wyolum/alamode/examples/train_demo/www/images/right.png

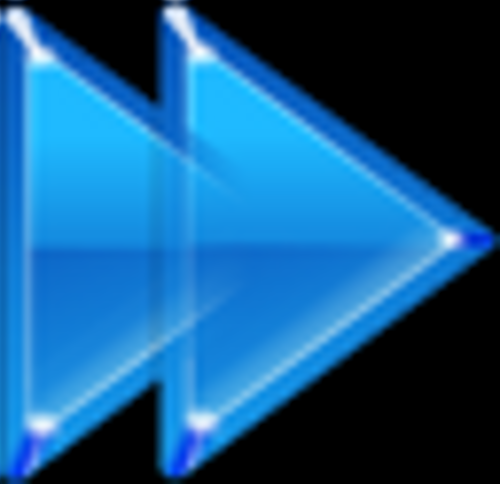
examples/train_demo/www/images/right.png
