wyolum/alamode/examples/train_demo/www/images/left.png

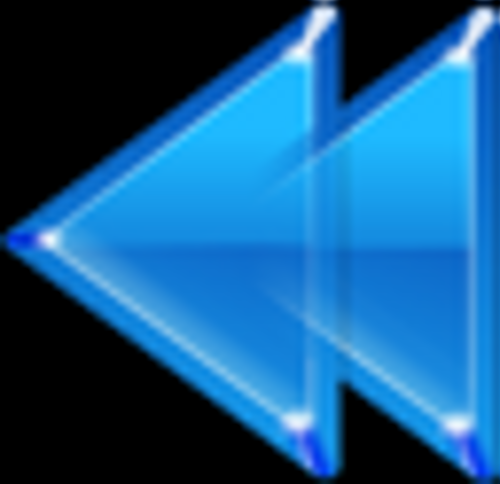
examples/train_demo/www/images/left.png
