wyolum/alamode/README.md

alamode
=======

Code, test code, and examples for the Alamode Arduino Compatible add on for Raspberry Pi.

License
-------
[CERN Open Hardware Licence v1.2 ]

[CERN Open Hardware Licence v1.2 ]:http://www.ohwr.org/attachments/2388/cern_ohl_v_1_2.txt
