wyolum/alamode/examples/train_demo/readme.md

Alamode Demo:

Control a lego train from a web interface.
Hardware requirements:
	Raspberry Pi
	AlaMode
	Adafruit Motor Shield
	Lego train (or other charged rail train system)
Software requirements:
	 Arduino IDE (or load alamode on another computer)
	 lighttpd (webserver). Could be adapted for other webservers such
	 as Apache.

Directory Structure:
alsmode-sketches: Copy these into your Arduino sketchbook
www: copy to /var/www or whatever your web root is
