wyolum/alamode/collateral/alamode sticker.png

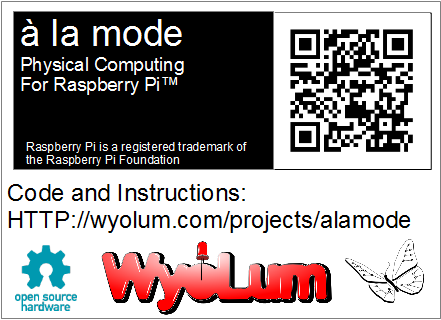
collateral/alamode sticker.png
