wyolum/alamode/examples/train_demo/www/images/but_left.png

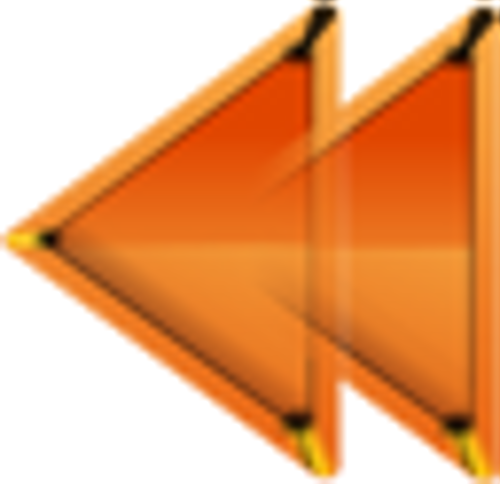
examples/train_demo/www/images/but_left.png
