wyolum/alamode/examples/train_demo/www/images/but_right.png

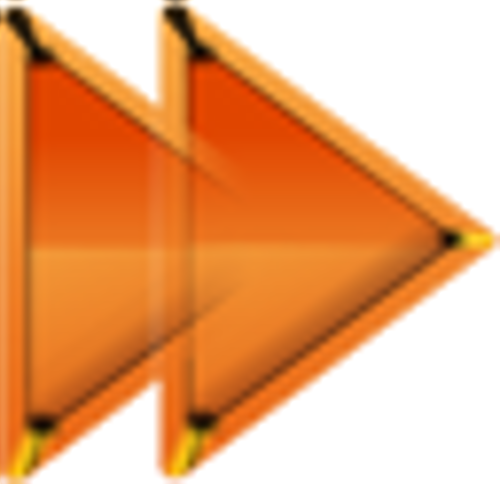
examples/train_demo/www/images/but_right.png
