wyolum/alamode/examples/train_demo/www/images/but_stop.png

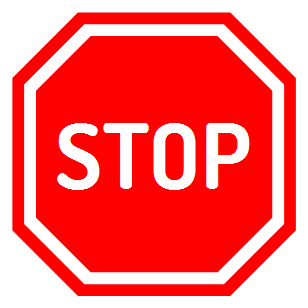
examples/train_demo/www/images/but_stop.png
