wyolum/alamode/examples/train_demo/www/images/WyoLum_v6.1.png

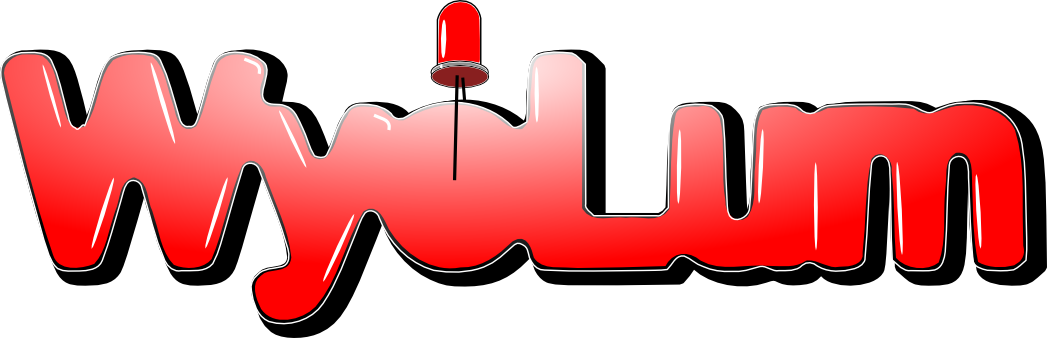
examples/train_demo/www/images/WyoLum_v6.1.png
