wyolum/alamode/kicad/Seeed BOM_aLamode_v3.ods

Sheet: Seeed BOM Format
Electronic Engineering BOM List
Product Name： WYOLUM AlaMode
Version：V3.0
Issue Date：29/Jul/2015
Item No. (序号) | Reference Des (上件位置) | Qty (用量) | Catalog (分类） | Part_Description (规格描述) | Part_Value （元件值） | Part_Package （元件封装） | Manufacturers Name (使用厂牌名称) | Manufacturers Part No. (使用厂牌型号) | Distributors Name （供应商名称） | Distributors Part No. (供貨商型号) | Unit Price （单价） | Price Break To Use （价格分段的购买量） | Notes/Remark （备注）
Example（填写范例）
1 | BT1 | 1 | OTHER | HOLDER COIN CELL 1632 GOLD SMD | Coin Cell, Holder, 1632 | CR1632 | MPD (Memory Protection Devices) | BU1632SM-JJ-GTR | Digikey (http://www.digikey.com/product-detail/en/BU1632SM-JJ-GTR/BU1632SM-JJ-GCT-ND/2079910) | BU1632SM-JJ-GCT-ND
2 | -- | 1 | OTHER | BATTERY LITHIUM COIN 3V 16MM | CR1632 | -- | Panasonic - BSG | CR1632 | DigiKey (http://www.digikey.com/product-detail/en/CR1632/P036-ND/269743?cur=USD) | P036-ND |  |  | DNP
3 | C1 C2 C4 C7 C9 C12 C13 C14 | 8 | Capacitor | CAP CER 0.1UF 25V 10% X7R 0805 | 100n 25V | 0805 (2012 Metric) | Kemet | C0805C104K3RACTU | DigiKey (http://www.digikey.com/product-detail/en/C0805C104K3RACTU/399-1168-1-ND/411443) | 399-1168-1-ND
4 | C3 | 1 | Capacitor | CAP TANT 2.2UF 10V 20% 0805 | 2u2 10V Tant | 0805 (2012 Metric) | Nichicon | F921A225MPA | DigiKey (http://www.digikey.com/product-detail/en/F921A225MPA/493-2331-1-ND/677799?cur=USD) | 493-2331-1-ND
5 | C5 | 1 | Capacitor | CAP CER 2.2UF 16V Y5V 0805 | 2u2, Ceramic | 0805 (2012 Metric) | TDK Corporation | C2012Y5V1C225Z/0.85 | DigiKey (http://goo.gl/59sIb) | 445-3459-1-ND
6 | C6 | 1 | Capacitor | CAP ALUM 100UF 25V 20% SMD | 100u, 25V | Radial, Can – SMD, 6.3diax7.7H,mm | Nichicon | UCL1E101MCL1GS | DigiKey (http://www.digikey.com/product-detail/en/UCL1E101MCL1GS/493-3937-1-ND/2300364) | 493-3937-1-ND
7 | C8 | 1 | Capacitor | CAP ALUM 47UF 10V 20% SMD | 47u, 10V | Radial, Can – SMD, 5.0diax5.4H,mm | Panasonic Electronic Components | EEE-1AA470WR | DigiKey (http://www.digikey.com/product-detail/en/EEE-1AA470WR/PCE3875CT-ND/766251?cur=USD) | PCE3875CT-ND
8 | C10 C11 | 2 | Capacitor | CAP CER 22PF 50V 5% NP0 0805 | 22p | 0805 (2012 Metric) | Kemet | C0805C220J5GACTU | DigiKey (http://www.digikey.com/product-detail/en/C0805C220J5GACTU/399-1113-1-ND/411388) | 399-1113-1-ND
9 | C15 | 1 | Capacitor | CAP CER 1000PF 50V 10% X7R 0805 | 1n | 0805 (2012 Metric) | Kemet | C0805C102K5RACTU | DigiKey (http://www.digikey.com/product-detail/en/C0805C102K5RACTU/399-1147-1-ND/411422) | 478-6218-1-ND
10 | C16 | 1 | Capacitor | CAP CER 10000PF 50V 10% X7R 0805 | 10n | 0805 (2012 Metric) | Kemet | C0805C103K5RACTU | DigiKey (http://www.digikey.com/product-detail/en/C0805C103K5RACTU/399-1158-1-ND/411433) | 399-1158-1-ND
11 | D1 D2 D13 | 3 | Diode | LED MINI TOPLED GREEN 570NM SMD | Green 1.8V 2mA LED | 2-SMD, J-Lead | OSRAM Opto Semiconductors Inc | LG M67K-H1J2-24-Z | DigiKey (http://www.digikey.com/product-detail/en/LG%20M67K-H1J2-24-Z/475-2730-1-ND/1938897?cur=USD) | 475-2730-1-ND
12 | D3 D4 | 2 | Diode | DIODE SCHOTTKY 5V 0.01A 2VMD | RB886G | 2-SMD, Flat Lead, VMD2 | Rohm Semiconductor | RB886GT2R | DigiKey (http://www.digikey.com/product-detail/en/RB886GT2R/RB886GT2RCT-ND/2425047?cur=USD) | RB886GT2RCT-ND
13 | D7 | 1 | Diode | TVS 600W 5.0V BI-DIR DO-214AA | SMBJ5.0CA-TR | DO-214AA, SMB | STMicroelectronics | SMBJ5.0CA-TR | DigiKey (http://www.digikey.com/product-detail/en/SMBJ5.0CA-TR/497-3145-1-ND/654466) | 497-3145-1-ND
14 | D8 | 1 | Diode | DIODE SCHOTTKY 10V 1A POWERMITE | MBRM110LT1G | DO-216AA | ON Semiconductor | MBRM110LT1G | DigiKey (http://www.digikey.com/product-detail/en/MBRM110LT1G/MBRM110LT1GOSCT-ND/917992) | MBRM110LT1GOSCT-ND
15 | F1 F2 | 2 | PROTECTOR CATEGORY | POLYSWITCH 1.10A RESET FUSE SMD | nanoSMDC110F | 1206 (3216 Metric), Concave, Long Side Terminals | TE Connectivity | NANOSMDC110F-2 | DigiKey (http://www.digikey.com/product-detail/en/NANOSMDC110F-2/NANOSMDC110FCT-ND/1045864) | NANOSMDC110FCT-ND
16 | IC1 | 1 | IC | IC MCU 8BIT 32KB FLASH 28DIP | ATMEGA328-PU | DIP-28__300_ELL | Atmel | ATMEGA328-PU | DigiKey (http://www.digikey.com/product-detail/en/ATMEGA328-PU/ATMEGA328-PU-ND/2271026?cur=USD) | ATMEGA328-PU-ND
17 | DIP1 | 1 | OTHER | CONN IC SOCKET VERT 28POS TIN | DIP28x0.3” | DIP28x0.3” | TE Connectivity | 1-390261-9 | DigiKey (http://www.digikey.com/product-detail/en/1-390261-9/A100210-ND/990628?cur=USD) | A100210-ND
18 | P12 | 1 | Connector | CONN USB MICRO B RECPT SMT R/A | USB - micro B | Surface Mount, Right Angle, Horizontal | FCI | 10118193-0001LF | DigiKey (http://www.digikey.com/product-detail/en/10118193-0001LF/609-4616-1-ND/2785380) | 609-4616-1-ND
19 | P16 | 1 | Connector | CONN HEADER 3POS 1.27MM SNGL SMD | 5V_LINK | Surface Mount 0.050" (1.27mm) | Samtec Inc | FTR-103-02-S-S | DigiKey (http://www.digikey.com/product-detail/en/FTR-103-02-S-S/FTR-103-02-S-S-ND/2651168) | FTR-103-02-S-S-ND
20 | Q1 | 1 | Transistor | MOSFET P-CH 20V 2A SSOT3 | FDN340P | SOT23-3 | Fairchild Semiconductor | FDN340P | DigiKey (http://www.digikey.com/product-detail/en/FDN340P/FDN340PCT-ND/965604) | FDN340PCT-ND
21 | R1 R2 R3 R4 R6 R7 R9 R10 R11 R13 | 10 | Resister | RES 10K OHM 1/8W 5% 0805 | 10k | 0805 (2012 Metric) | Stackpole Electronics Inc | RMCF0805JT10K0 | DigiKey (http://www.digikey.com/product-detail/en/RMCF0805JT10K0/RMCF0805JT10K0CT-ND/1942577) | RMCF0805JT10K0CT-ND
22 | R5 R8 | 2 | Resister | RES 1.5K OHM 1/8W 5% 0805 | 1k5 | 0805 (2012 Metric) | Stackpole Electronics Inc | RMCF0805JT1K50 | DigiKey (http://www.digikey.com/product-detail/en/RMCF0805JT1K50/RMCF0805JT1K50CT-ND/1942560) | RMCF0805JT1K50CT-ND
23 | R12 | 1 | Resister | RES 1K OHM 1/8W 5% 0805 | 1k | 0805 (2012 Metric) | Stackpole Electronics Inc | RMCF0805JT1K00 | DigiKey (http://www.digikey.com/product-detail/en/RMCF0805JT1K00/RMCF0805JT1K00CT-ND/1942557) | RMCF0805JT1K00CT-ND
24 | R14 | 1 | Resister | RES 0.0 OHM 1/8W JUMP 0805 | 0E | 0805 (2012 Metric) | Stackpole Electronics Inc | RMCF0805ZT0R00 | DigiKey (http://www.digikey.com/product-detail/en/RMCF0805ZT0R00/RMCF0805ZT0R00CT-ND/1942606) | RMCF0805ZT0R00CT-ND
25 | R15 | 1 | Resister | RES 8.2K OHM 1/8W 5% 0805 | 8k2 | 0805 (2012 Metric) | Stackpole Electronics Inc | RMCF0805JT8K20 | DigiKey (http://www.digikey.com/product-detail/en/RMCF0805JT8K20/RMCF0805JT8K20CT-ND/1942575) | RMCF0805JT8K20CT-ND
26 | R16 | 1 | Resister | RES 16K OHM 1/8W 5% 0805 SMD | 16k | 0805 (2012 Metric) | Yageo | RC0805JR-0716KL | DigiKey (http://www.digikey.com/product-detail/en/RC0805JR-0716KL/311-16KARCT-ND/731209) | 311-16KARCT-ND
27 | SD1 | 1 | Connector | Micro SD Card Socket | SD_CARD_MICRO | SD_Micro | ? | ? | seeed | ST-SD-006A
28 | SW1 | 1 | OTHER | SWITCH TACTILE SPST-NO 0.02A 15V | RST | Surface Mount 4.70mm x 3.50mm | Panasonic Electronic Components | EVQ-P2602W | DigiKey (http://www.digikey.com/product-detail/en/EVQ-P2602W/P12301SCT-ND/593601?cur=USD) | P12301SCT-ND
29 | U1 | 1 | IC | IC REG LDO 3.3V 0.15A SOT23-5 | LP2985-33DBVR | SOT23-5 | Texas Instruments | LP2985-33DBVR | DigiKey (http://www.digikey.com/product-detail/en/LP2985-33DBVR/296-18476-1-ND/809911) | 296-18476-1-ND
30 | U2 | 1 | IC | IC BUFF TRI-ST QD N-INV 14SOIC | 74HC125 | 14-SOIC (0.154", 3.90mm Width) | ON Semiconductor | MC74HC125ADG | DigiKey (http://www.digikey.com/product-detail/en/MC74HC125ADG/MC74HC125ADGOS-ND/1479839?cur=USD) | MC74HC125ADGOS-ND
31 | U4 | 1 | IC | IC RTC W/TCXO 16-SOIC | DS3231N | 16-SOIC (0.295", 7.50mm Width) | Maxim Integrated Products | DS3231S# | DigiKey (http://goo.gl/gg9GS) | DS3231S#-ND
32 | U5 | 1 | IC | IC OP AMP LOW PWR DUAL 8-SOIC | LM358N | 8-SOIC (0.154", 3.90mm Width) | STMicroelectronics | LM358ADT | DigiKey (http://www.digikey.com/product-detail/en/LM358ADT/497-1590-1-ND/592082) | 497-1590-1-ND
33 | U6 | 1 | IC | IC 8BIT NON-INV TRANSLTR 20TSSOP | TXS0108 | 20-TSSOP (0.173", 4.40mm Width) | Texas Instruments | TXS0108EPWR | DigiKey (http://www.digikey.com/product-detail/en/TXS0108EPWR/296-23011-1-ND/1775304) | 296-23011-1-ND
34 | X1 | 1 | OTHER | CRYSTAL 16.000MHZ 8PF SMD | 16MHz | 4-SMD, No Lead (DFN, LCC) | AVX Corporation | CX3225GB16000D0HEQZ1 | DigiKey (http://www.digikey.com/product-detail/en/CX3225GB16000D0HEQZ1/478-6622-1-ND/2665884?cur=USD) | 478-6622-1-ND
35 | JP16 | 1 | Connector | CONN SHUNT 1.27MM BLACK | JUMPER, for P16 |  | TE Connectivity | 382811-8 | DigiKey (http://www.digikey.com/product-detail/en/M50-1900005/952-1730-ND/2890862) | 952-1730-ND
1. Recommended Distributor: Digi-Key, Mouser, Avnet Express, Farnell.
2. Catalog: Capacitor,Resister,Diode,Connector,Transistor,IC,PROTECTOR CATEGORY,OTHER
3. Required Fields: Item No, Reference Des, Qty, Catalog, Part_Value, Part Package
Optional Fields: Part_Description, Manufacturers Name, Manufacturers Part No, Distributors Name, Distributors Part No, Unit Cost, Price break to use, Notes/Remark

Sheet: Connectors_Kit
Item No. (序号) | Reference Des (上件位置) | Qty (用量) | Catalog (分类） | Part_Description (规格描述) | Part_Value （元件值） | Part_Package （元件封装） | Manufacturers Name (使用厂牌名称) | Manufacturers Part No. (使用厂牌型号) | Distributors Name （供应商名称） | Distributors Part No. (供貨商型号) | Unit Price （单价） | Price Break To Use （价格分段的购买量） | Notes/Remark （备注）
1 | P1 | 1 | Connector | Header, female, 13x2 | BCM2835_GPIO | Header_GPIO | 4Uconnector.com | 08407-0197 | 4Uconnector.com (http://www.4uconnector.com/online/object/4udrawing/08407.pdf) | 08407-0197 |  |  | DNP
2 | P4 | 1 | Connector | Header, Male, 8x1 | PWM_SERVO | Header_Servo | Sullins Connector Solutions | PREC008SAAN-RC | DigiKey (http://www.digikey.com/product-detail/en/PREC008SAAN-RC/S1012EC-08-ND/2774846) | S1012EC-08-ND |  |  | DNP
3 | P5 | 1 | Connector | Header, Male, 8x1 | 5V_SERVO | Header_Servo | Sullins Connector Solutions | PREC008SAAN-RC | DigiKey (http://www.digikey.com/product-detail/en/PREC008SAAN-RC/S1012EC-08-ND/2774846) | S1012EC-08-ND |  |  | DNP
4 | P6 | 1 | Connector | Header, Male, 8x1 | GND_SERVO | Header_Servo | Sullins Connector Solutions | PREC008SAAN-RC | DigiKey (http://www.digikey.com/product-detail/en/PREC008SAAN-RC/S1012EC-08-ND/2774846) | S1012EC-08-ND |  |  | DNP
5 | P8 | 1 | Connector | Header, Male, 6x1 | FTDI | Header_FTDI | Sullins Connector Solutions | PREC006SAAN-RC | DigiKey (http://www.digikey.com/product-detail/en/PREC006SAAN-RC/S1012EC-06-ND/2774848) | S1012EC-06-ND |  |  | DNP
6 | P14 | 1 | Connector | Header, Female, 6x1 | ANALOG_5V0 | Header_6x1 | Sullins Connector Solutions | PPPC061LFBN-RC | DigiKey (http://www.digikey.com/scripts/DkSearch/dksus.dll?WT.z_header=search_go&lang=en&x=0&y=0&cur=USD) | S7039-ND |  |  | DNP
7 | P15 | 1 | Connector | Header, Female, 6x1 | ANALOG_GND | Header_6x1 | Sullins Connector Solutions | PPPC061LFBN-RC | DigiKey (http://www.digikey.com/scripts/DkSearch/dksus.dll?WT.z_header=search_go&lang=en&x=0&y=0&cur=USD) | S7039-ND |  |  | DNP
8 | ANALOG | 1 | Connector | Header, Female, 6x1 | ANALOG | Header_6x1 | Sullins Connector Solutions | PPPC061LFBN-RC | DigiKey (http://www.digikey.com/scripts/DkSearch/dksus.dll?WT.z_header=search_go&lang=en&x=0&y=0&cur=USD) | S7039-ND |  |  | DNP
9 | POWER | 1 | Connector | Header, Female, 8x1 | POWER | Header_8x1 | Sullins Connector Solutions | PPPC081LFBN-RC | DigiKey (http://www.digikey.com/scripts/DkSearch/dksus.dll?WT.z_header=search_go&lang=en&x=0&y=0&cur=USD) | S7041-ND |  |  | DNP
10 | I/O L | 1 | Connector | Header, Female, 8x1 | I/O L | Header_8x1 | Sullins Connector Solutions | PPPC081LFBN-RC | DigiKey (http://www.digikey.com/scripts/DkSearch/dksus.dll?WT.z_header=search_go&lang=en&x=0&y=0&cur=USD) | S7041-ND |  |  | DNP
11 | I/O H | 1 | Connector | Header, Female, 10x1 | I/O H | Header_10x1 | Sullins Connector Solutions | PPPC101LFBN-RC | DigiKey (http://www.digikey.com/product-search/en?x=0&y=0&lang=en&site=us&KeyWords=S7043-ND) | S7043-ND |  |  | DNP
12 | -- | 1 | OTHER | BUMPON SQUARE .40X.10 BLACK | 3M Bumpon Protective Products SJ5007 Black | Square, tapered, Polyurethane Adhesive Bumper | 3M or similar | SJ-5007 (BLACK) | DigiKey (http://www.digikey.com/product-search/en?x=-1184&y=-71&lang=en&site=us&KeyWords=SJ5007-0-ND) | SJ5007-0-ND |  |  | DNP
