wyolum/alamode/(threads)

Thread 3 (2017-09-02):

Need new setup for Stretch?

Kalsta, 2017-09-02:
Hi there,

It would appear that the Jessie setup does not work on Stretch, so perhaps they have changed something that has broken it.

Is there any ETA on a Stretch version?

Cheers,

Kal

osbock, 2017-09-03:
I'll take a look at it. The basic steps are:
1. disable serial console and login
2. install arduino
3. run our patch script that replaces avrdude with an alamode compatible
version.
It's not too hard to do those steps manually if you have instructions for
stretch.

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

Kalsta, 2017-09-03:
Hi there,

Thanks for getting back to me so quickly!

On the same hardware, with the same config, but with Jessie on one SD card and Stretch on another, here's the logs for both:

[Jessie.txt](https://github.com/wyolum/alamode/files/1272810/Jessie.txt)
[Stretch.txt](https://github.com/wyolum/alamode/files/1272809/Stretch.txt)

Hopefully this helps?

Cheers,

Kal

Kalsta, 2017-09-03:
Also these were the install steps on both Jessie and Stretch:

```
sudo apt-get update
sudo apt-get install arduino
sudo apt-get install dos2unix
wget https://github.com/wyolum/alamode/raw/master/bundles/alamode-setup.tar.gz
tar -xvzf alamode-setup.tar.gz
cd alamode-setup
sudo dos2unix jessie-setup
sudo ./jessie-setup
```

osbock, 2017-09-13:
I'm travelling, but I happen to have a Raspi, but not an alamode, but I
think I've figured it out.
they changed the name of the serialport in cmdline.txt.
getty is now disabled by default, so I also commented that out.
download stretch-setup from
https://raw.githubusercontent.com/wyolum/alamode/master/alamode-setup/stretch-setup
(e.g.:
wget
https://raw.githubusercontent.com/wyolum/alamode/master/alamode-setup/stretch-setup

)
into the alamode-setup directory, and run it sudo:
cd alamode-setup
sudo ./stretch-setup
reboot.
Let me know if it works or not. I'll have access to an alamode this
weekend, so I can do more testing.

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

Kalsta, 2017-09-13:
Thanks Kevin, really appreciate you looking into this whilst abroad!

I'll give it a test tonight and report back to you.

Cheers,

Kal

Kalsta, 2017-09-13:
Hi Kevin,

It looks like we are getting some two way communication now, but it fails before it finishes (see attached log).

Cheers,

Kal
[stretch2.txt](https://github.com/wyolum/alamode/files/1298423/stretch2.txt)

Kalsta, 2017-09-13:
Not sure if this helps, but I've attached the sketch I've been trying to upload (I had to convert it to .txt because .ino files not allowed).

Cheers,

Kal
[raspberrypints.txt](https://github.com/wyolum/alamode/files/1298551/raspberrypints.txt)

Thread 4 (2017-11-19):

use avrdude linuxspi/linuxgpio programmer

chrstphrchvz, 2017-11-19:
As long as the linuxspi or linuxgpio programmers were enabled at compile time, there shouldn't be a need for patching avrdude with a separate programmer for alamode. Arduino IDE (not through Raspbian) includes avrdude with the linuxgpio programmer, and the Raspbian build of avrdude also includes the linuxspi programmer.

I haven't figured out all the steps to successfully use this myself, but it would probably involve updating the avrdude.conf and/or programmers.txt.

(n.b.: I think this is what ArduBerry is using.)

chrstphrchvz, 2018-01-13:
Update: I successfully flashed the `optiboot_atmega328.hex` bootloader and uploaded a sketch to the alamode using the both the linuxgpio and linuxspi programmers. E.g. for linuxspi, in `avrdude.conf` I specified reset on gpio pin 18 (header pin 12):
```
programmer
  id = "linuxspi";
  desc = "Use Linux SPI device in /dev/spidev*";
  type = "linuxspi";
  reset = 18;
  baudrate=400000;
;
```

To clarify, the linuxspi programmer is [not yet officially included in avrdude](https://savannah.nongnu.org/patch/?8228) nor the official Arduino IDE download's avrdude, rather it is a patch that debian and probably others downstream include by popular demand.

I haven't yet figured out how to have this appear in the Arduino IDE, but there might also still be a bug in either avrdude or udev that pose an issue trying it out anyways (sleeping long enough for udev to fix permissions on the gpio sysfs stuff; I ran avrdude as root as a workaround).

chrstphrchvz, 2020-11-26:
Update: as of sometime later in 2018, Arduino's avrdude now includes linuxspi.

Thread 5 (2017-12-18):

boards.txt is not up to date for arduino studio 1.8.5

simotek, 2017-12-18:
Board alamode:avr:alamode doesn't define a 'build.board' preference. Auto-set to: AVR_ALAMODE`
recipe.preproc.macros pattern is missing

Error compiling for board AlaMode.

osbock, 2017-12-19:
Do you have a fix?

simotek, 2017-12-19:
Unfortunately not at the moment, I just tried changing the code on my alamode for the first time in a couple of years and hit the above issue. Its not a area i'm normally that active in.

osbock, 2017-12-19:
OK. thanks I'll look into it.

Thread 7 (2019-07-20):

cant find setup file

silverardo52, 2019-07-20:
trying to run setup file in the latest version of Raspian please read following conversation i had on Core forum.
Ok I setup new sd card with latest NOOBS rebooted pi went to Wyolm web sit downloaded wget https://github.com/wyolum/alamode/raw/master/bundles/alamode-setup.tar.gz
that worked fine
then pi@raspberrypi ~ $ tar -xvzf alamode-setup.tar.gz that works fine then pi@raspberrypi ~ $ sudo ./setup I get “sudo: ./setup: command not found”
I then opened pi@raspberrpi~/alamode-setup $ sudo ./setup [/code] and got "sudo: unable to execute ./setup: no such file or directory
I had the same issue. Somebody has been editing the file in their Windows environment without turning off CRLF (when you hit enter it adds carriage+return, line-feed). Linux only has the LF and tries to interpret the CR as a part of the command.

The easy way to fix it is to install the program dos2unix as follows:

Copy to clipboard
sudo apt-get install dos2unix
Once you’ve installed dos2unix type the commands as follows:

Copy to clipboard
wget https://github.com/wyolum/alamode/raw/master/bundles/alamode-setup.tar.gz
tar -xvzf alamode-setup.tar.gz
cd alamode-setup
dos2unix setup
chmod +x setup
sudo ./setup
Daryl87976
14h
Thanks for the help Shaun but I followed your instruction all work good until
sudo ./setup
I got sed: can't read /etc/inittab:No such file or directory
rm: cannot remove '/etc/inittabbk': No such file or directory
