wyolum/alamode/kicad/pdf/aLaMode_v3.pdf

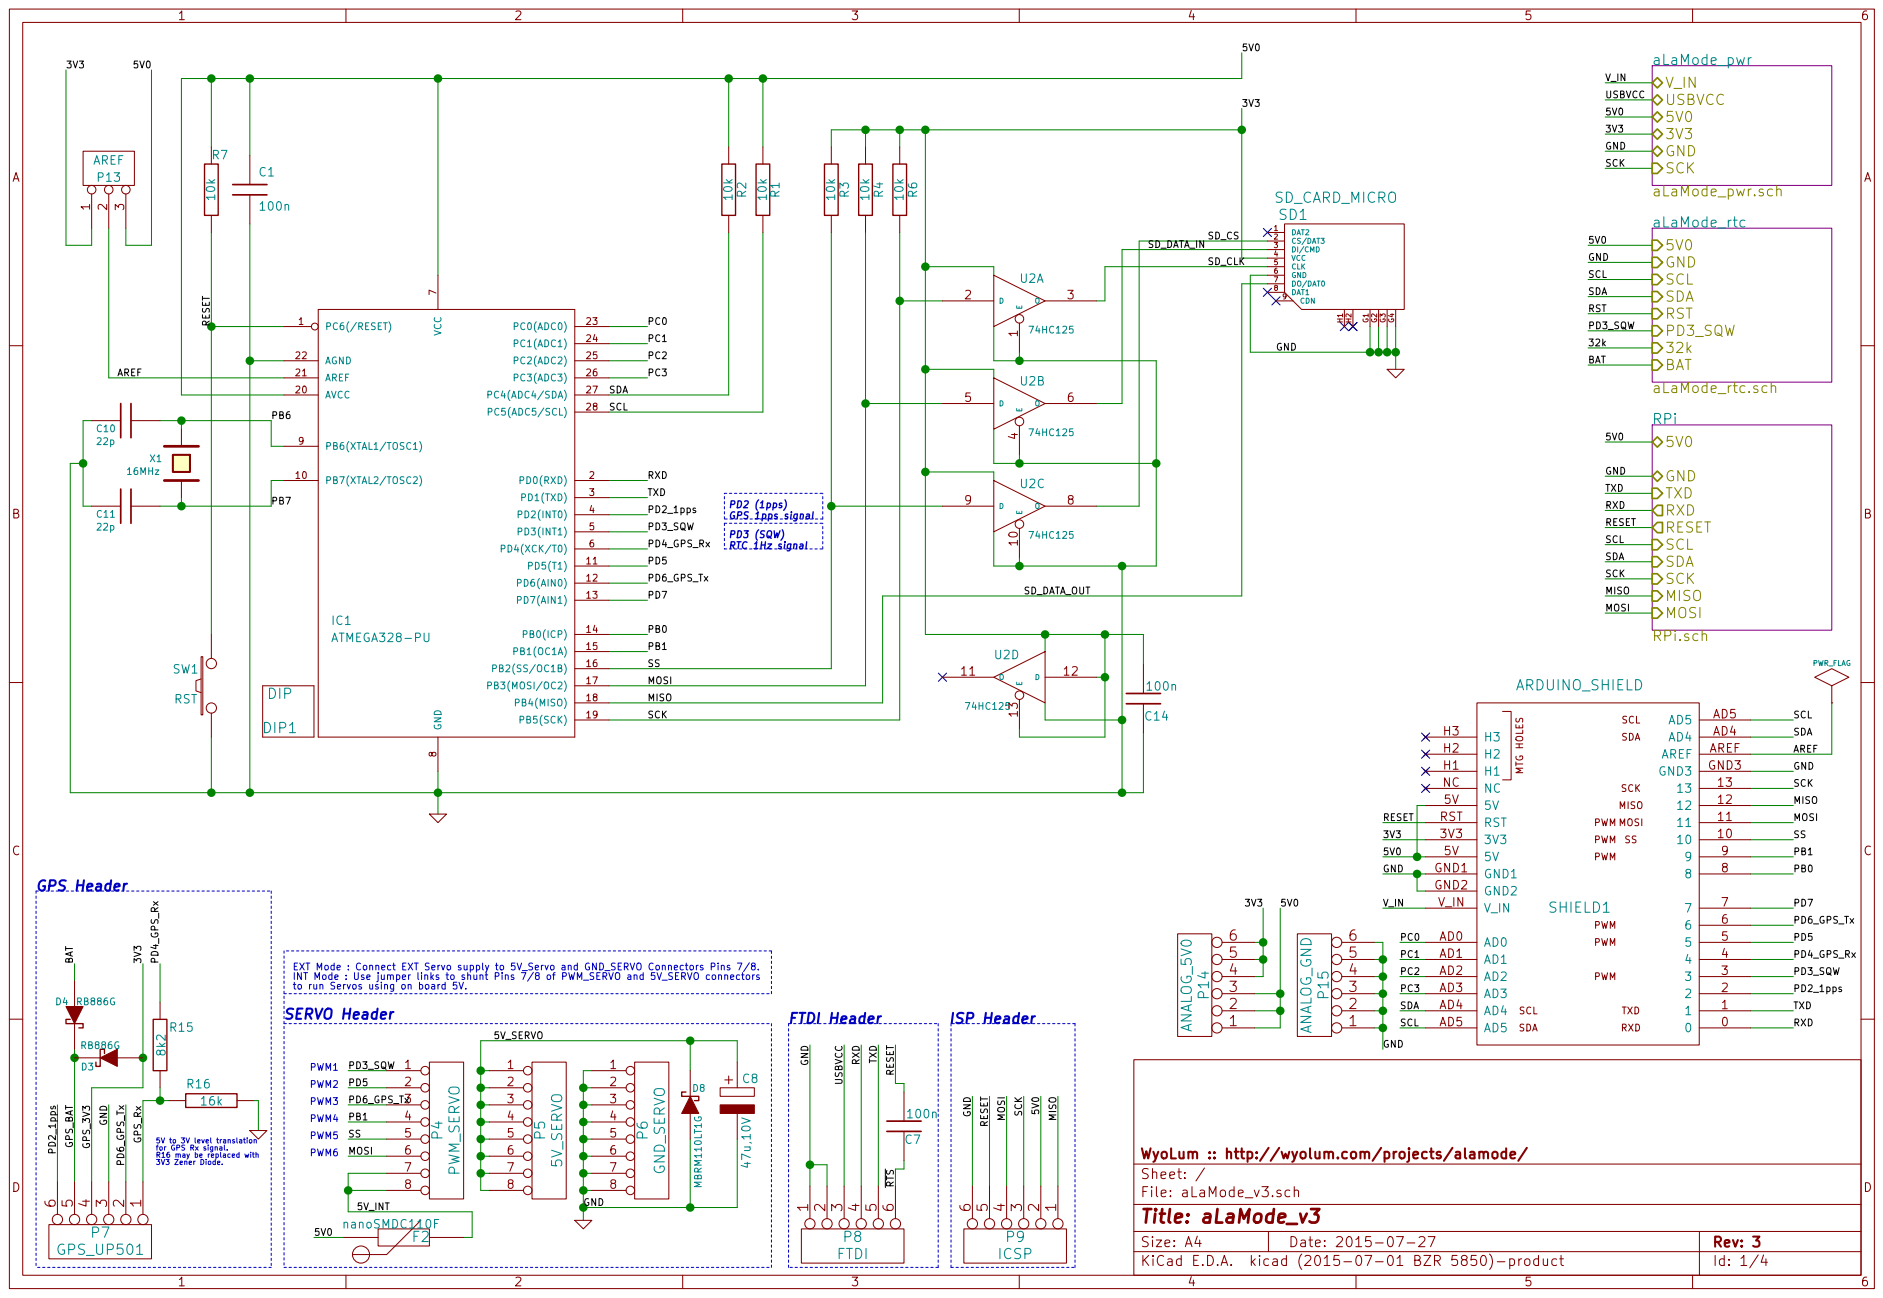
[picture p8: page 1]

8 PB6(XTAL1/TOSC1) 9 PB7(XTAL2/TOSC2) 10 AVCC 20 PD5(T1) 11 AREF 21 PD6(AIN0) 12 AGND 22 PD7(AIN1) 13 PC0(ADC0) 23 PB0(ICP) 14 PC1(ADC1) 24 PB1(OC1A) 15 PC2(ADC2) 25 PB2(SS/OC1B) 16 PC3(ADC3) 26 PB3(MOSI/OC2) 17 PC4(ADC4/SDA) 27 PB4(MISO) 18 PC5(ADC5/SCL) 28 PB5(SCK) 19

TXD
RXD
MISO MOSI MTG HOLES

EXT Mode : Connect EXT Servo supply to 5V_Servo and GND_SERVO Connectors Pins 7/8.
INT Mode : Use jumper links to shunt Pins 7/8 of PWM_SERVO and 5V_SERVO connectors

5V to 3V level translation
for GPS Rx signal. R16 may be replaced with
3V3 Zener Diode.

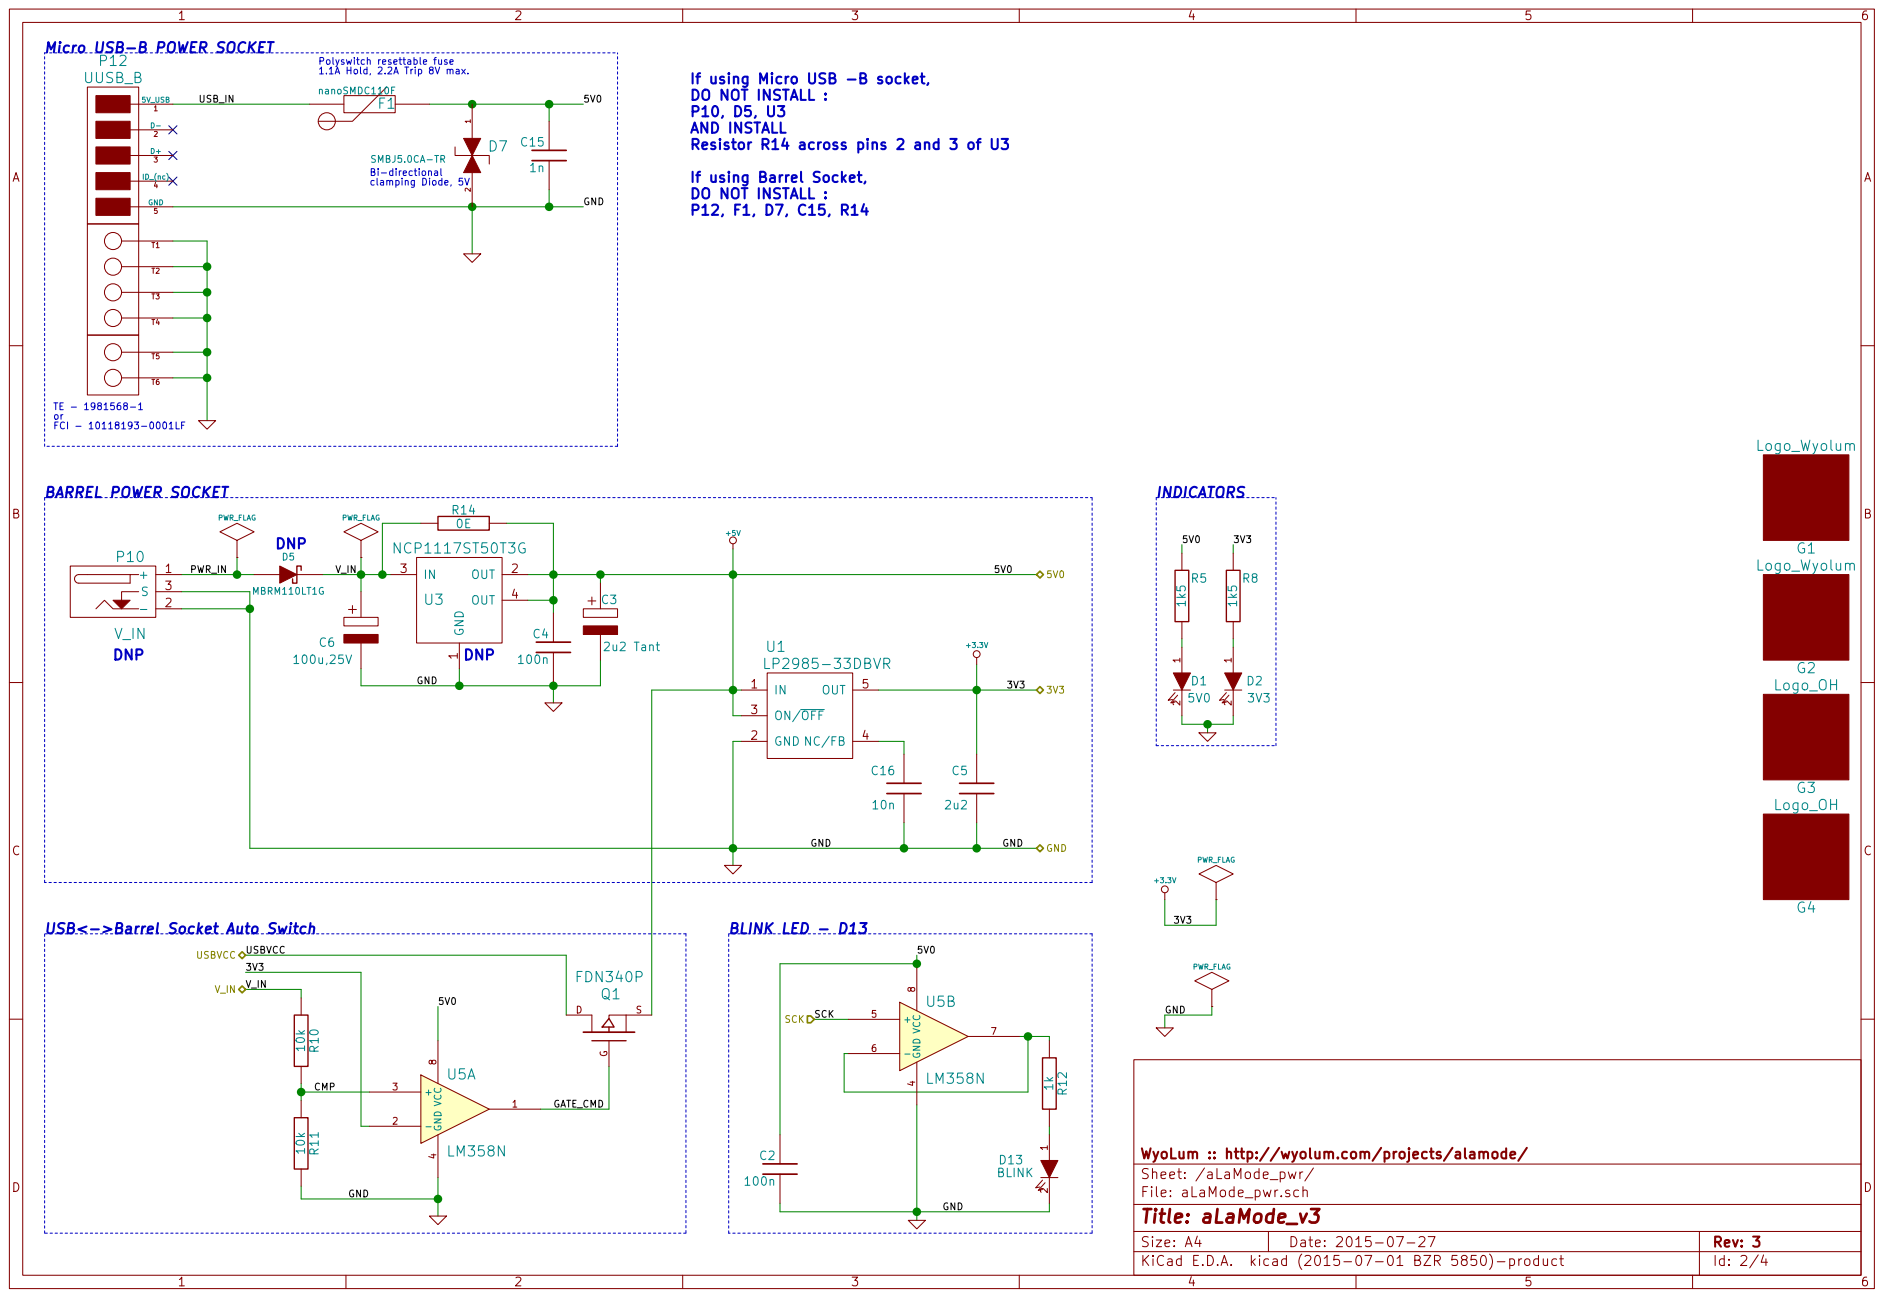
[picture p9: page 2]

Micro USB-B POWER SOCKET
5T1T2T3T4T5T6 P12 UUSB_B
1.1A Hold, 2.2A Trip 8V max. PWR_IN

If using Micro USB -B socket,
DO NOT INSTALL :
AND INSTALL
Resistor R14 across pins 2 and 3 of U3

If using Barrel Socket,

GND USB<->Barrel Socket Auto Switch

WyoLum :: http://wyolum.com/projects/alamode/
Sheet: /aLaMode_pwr/
File: aLaMode_pwr.sch
Id: 2/4 Title: aLaMode_v3

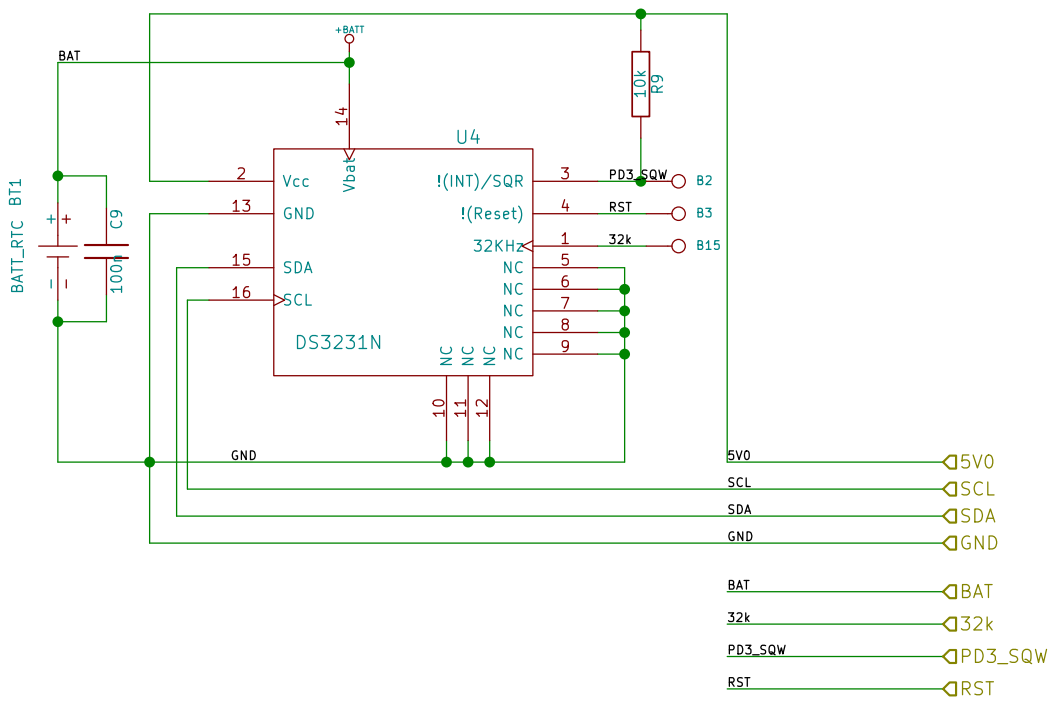
[picture p10: page 3]

WyoLum :: http://wyolum.com/projects/alamode/ RST PD3_SQW

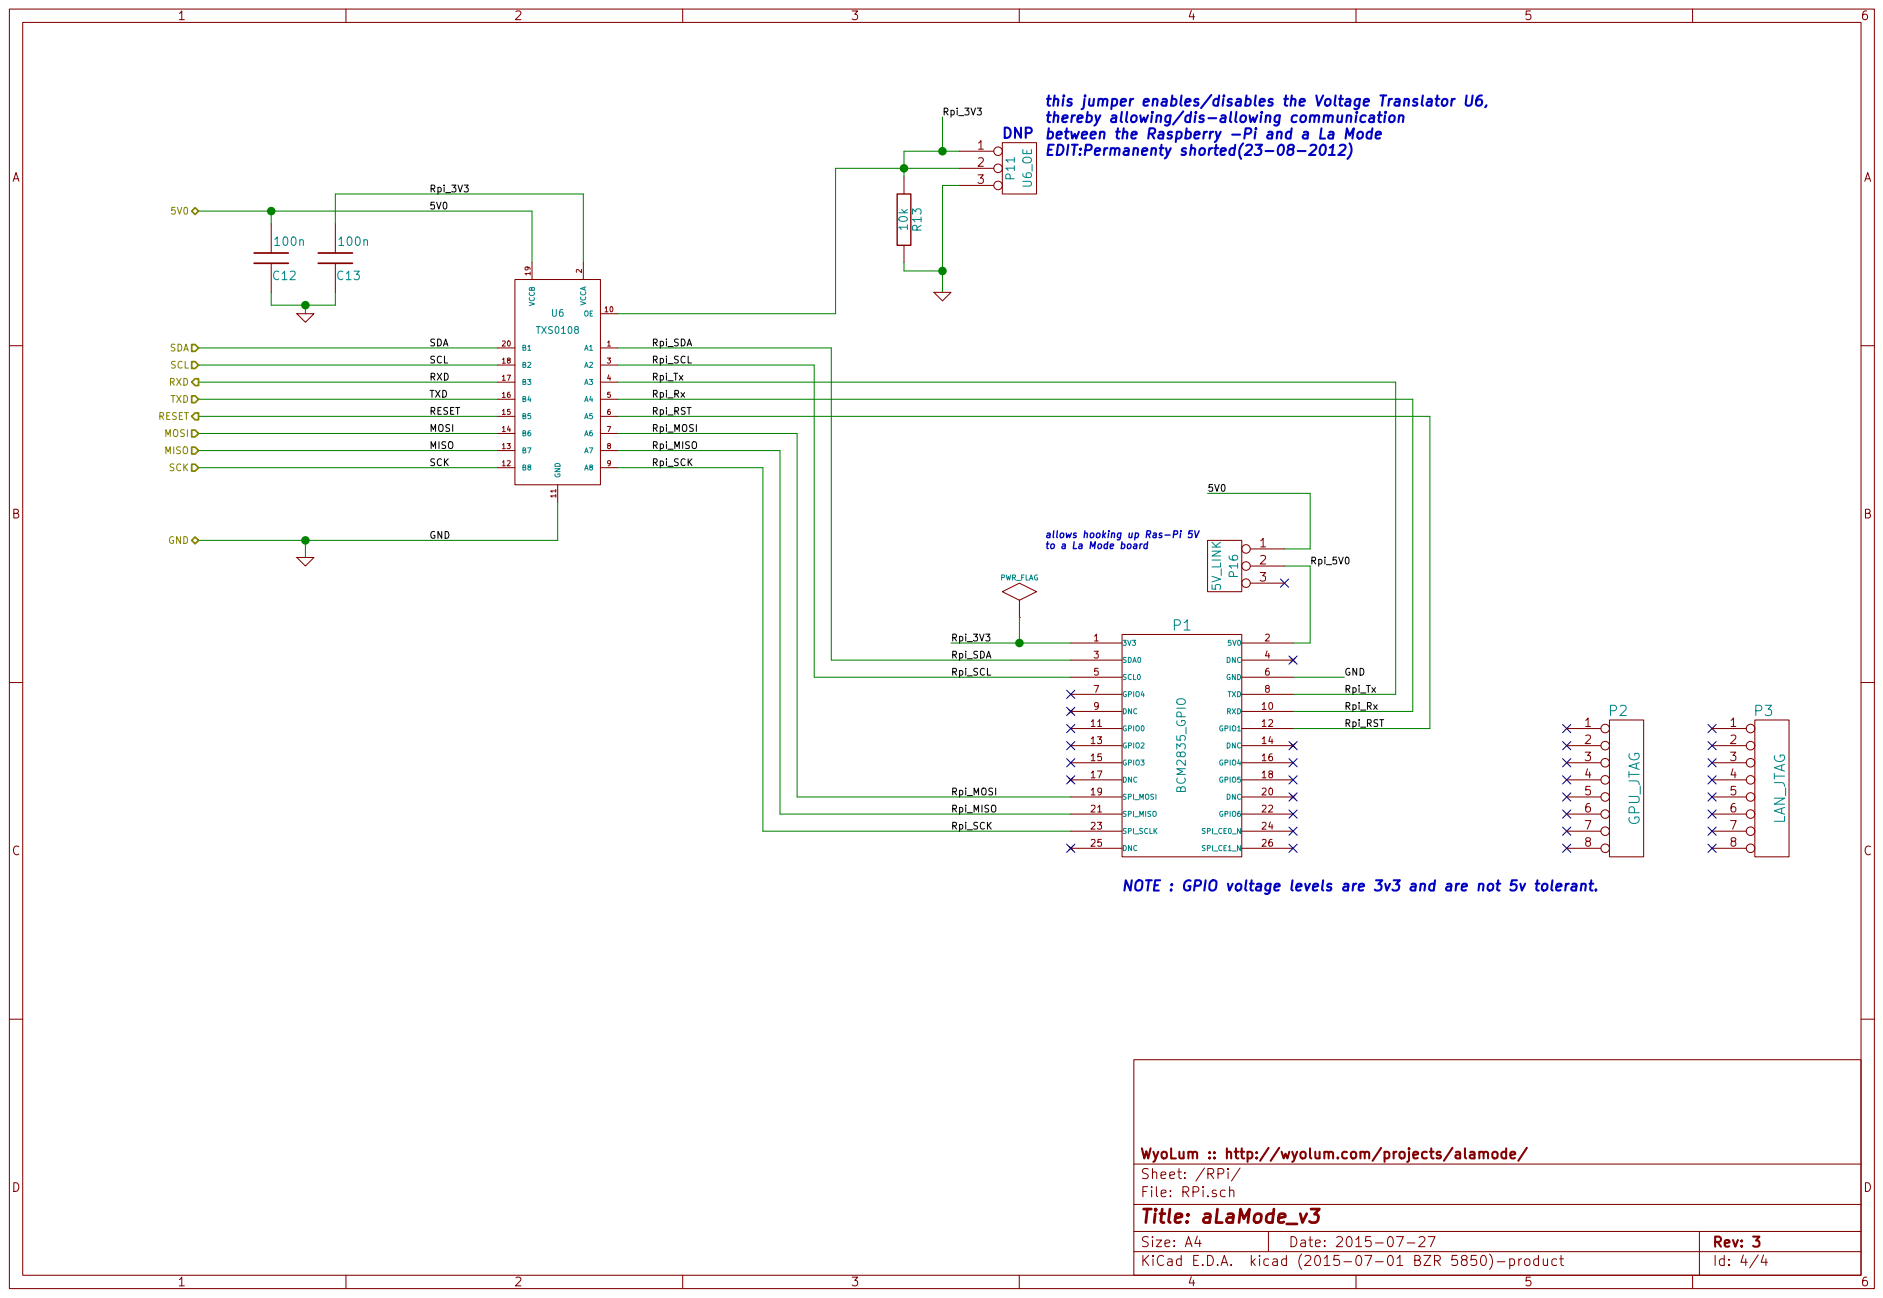
[picture p11: page 4]

this jumper enables/disables the Voltage Translator U6,
thereby allowing/dis-allowing communication
PWR_FLAG DNP
between the Raspberry -Pi and a La Mode
EDIT:Permanenty shorted(23-08-2012)

allows hooking up Ras-Pi 5V to a La Mode board
