wyolum/alamode/kicad/pdf/aLaMode_v3-B_Cu.pdf

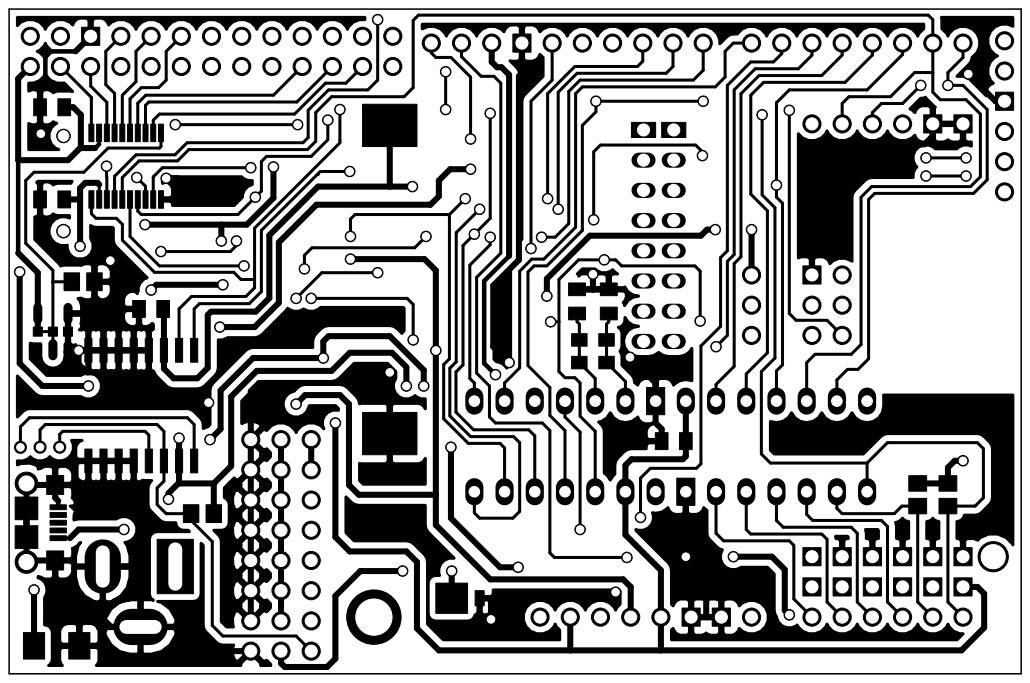
[picture p12: page 1]
