wyolum/alamode/kicad/pdf/aLaMode_v3-B_SilkS.pdf

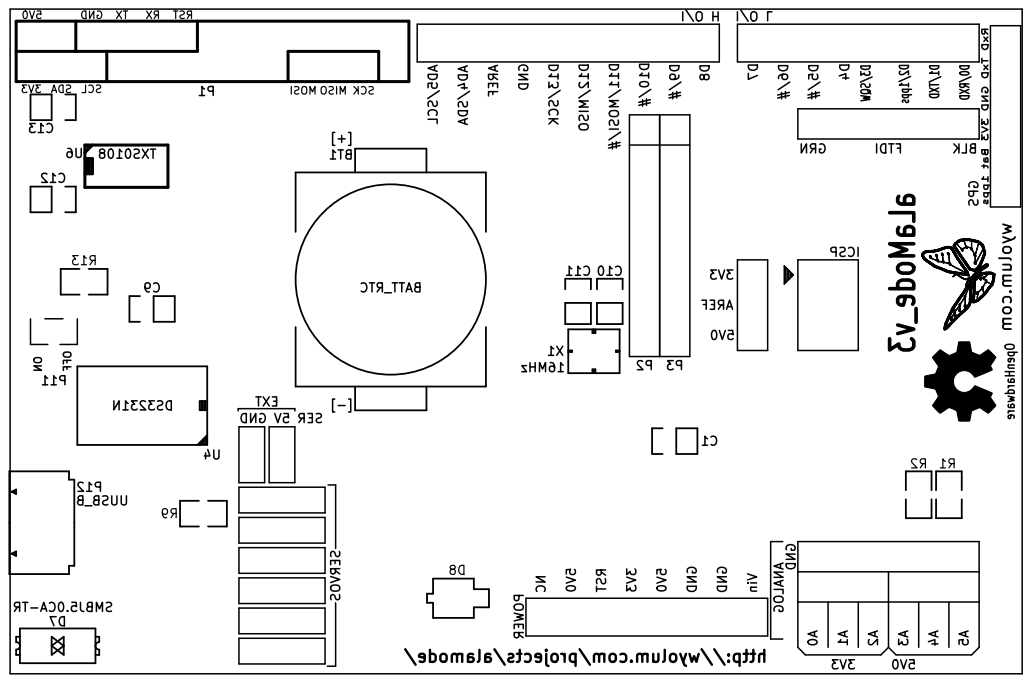
[picture p13: page 1]
