wyolum/alamode/kicad/pdf/aLaMode_v3-Dwgs_User.pdf

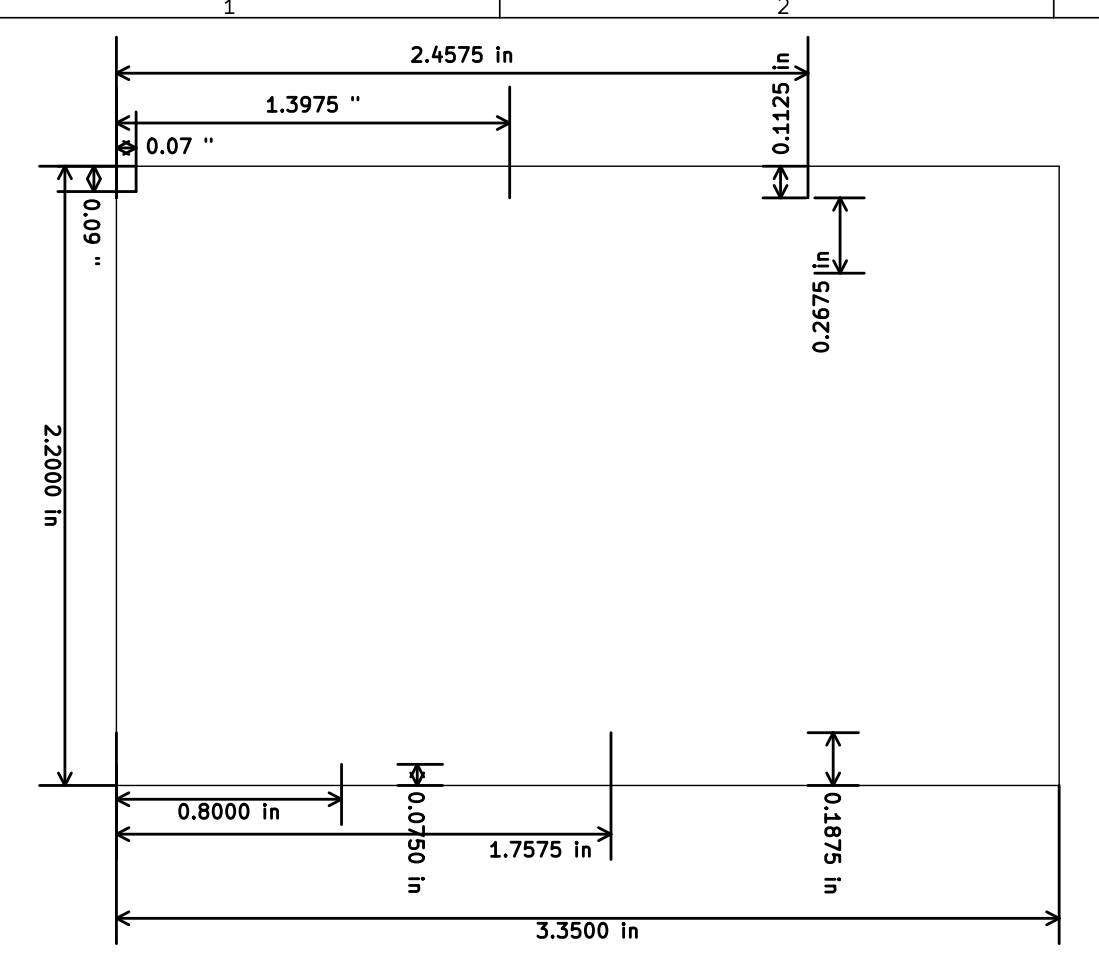
[picture p14: page 1]
