wyolum/alamode/kicad/pdf/aLaMode_v3-F_Cu.pdf

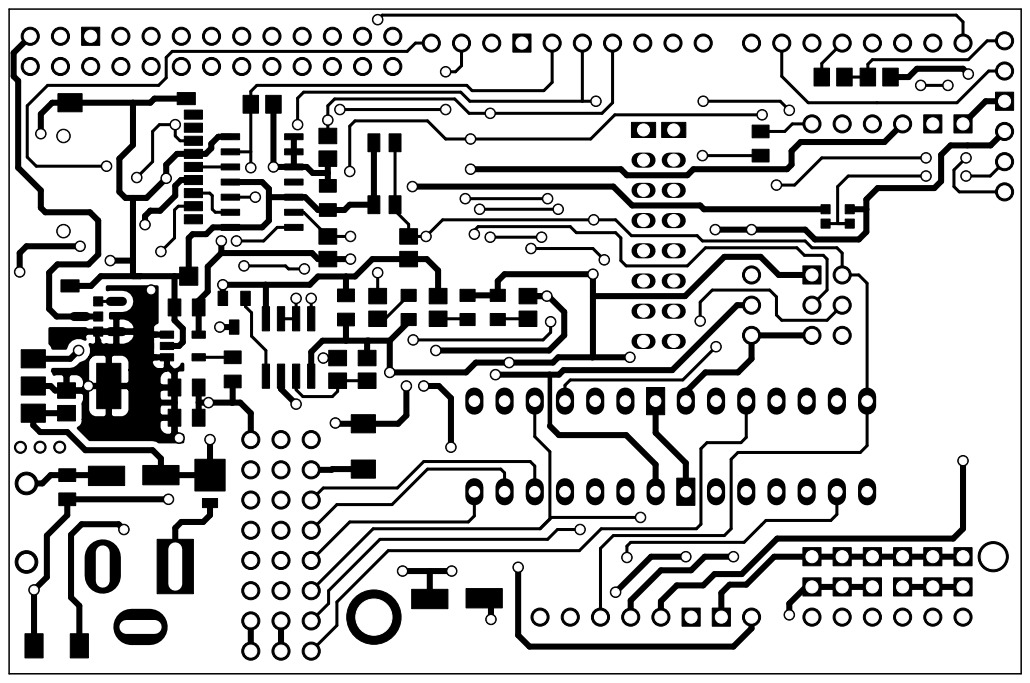
[picture p15: page 1]
