wyolum/alamode/kicad/pdf/aLaMode_v3-F_SilkS.pdf

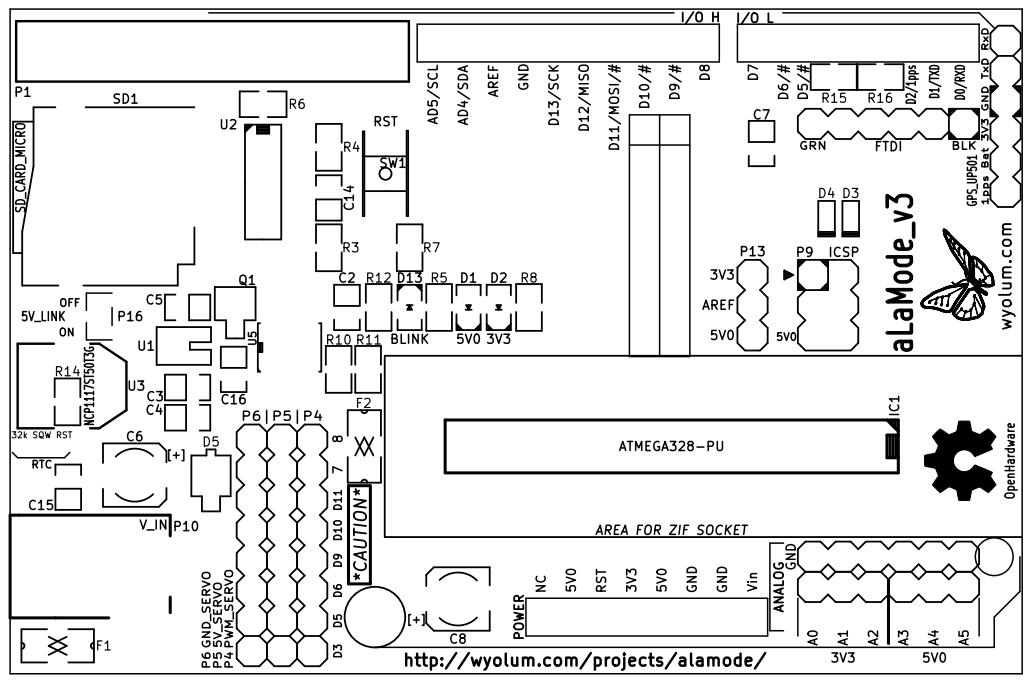
[picture p16: page 1]

8 7 P6|P5|P4 http://wyolum.com/projects/alamode/ RTC
