wyolum/alamode/kicad/aLaMode_v3.kicad_pcb

## KiCad design kicad/aLaMode_v3.kicad_pcb (2015-07-29)

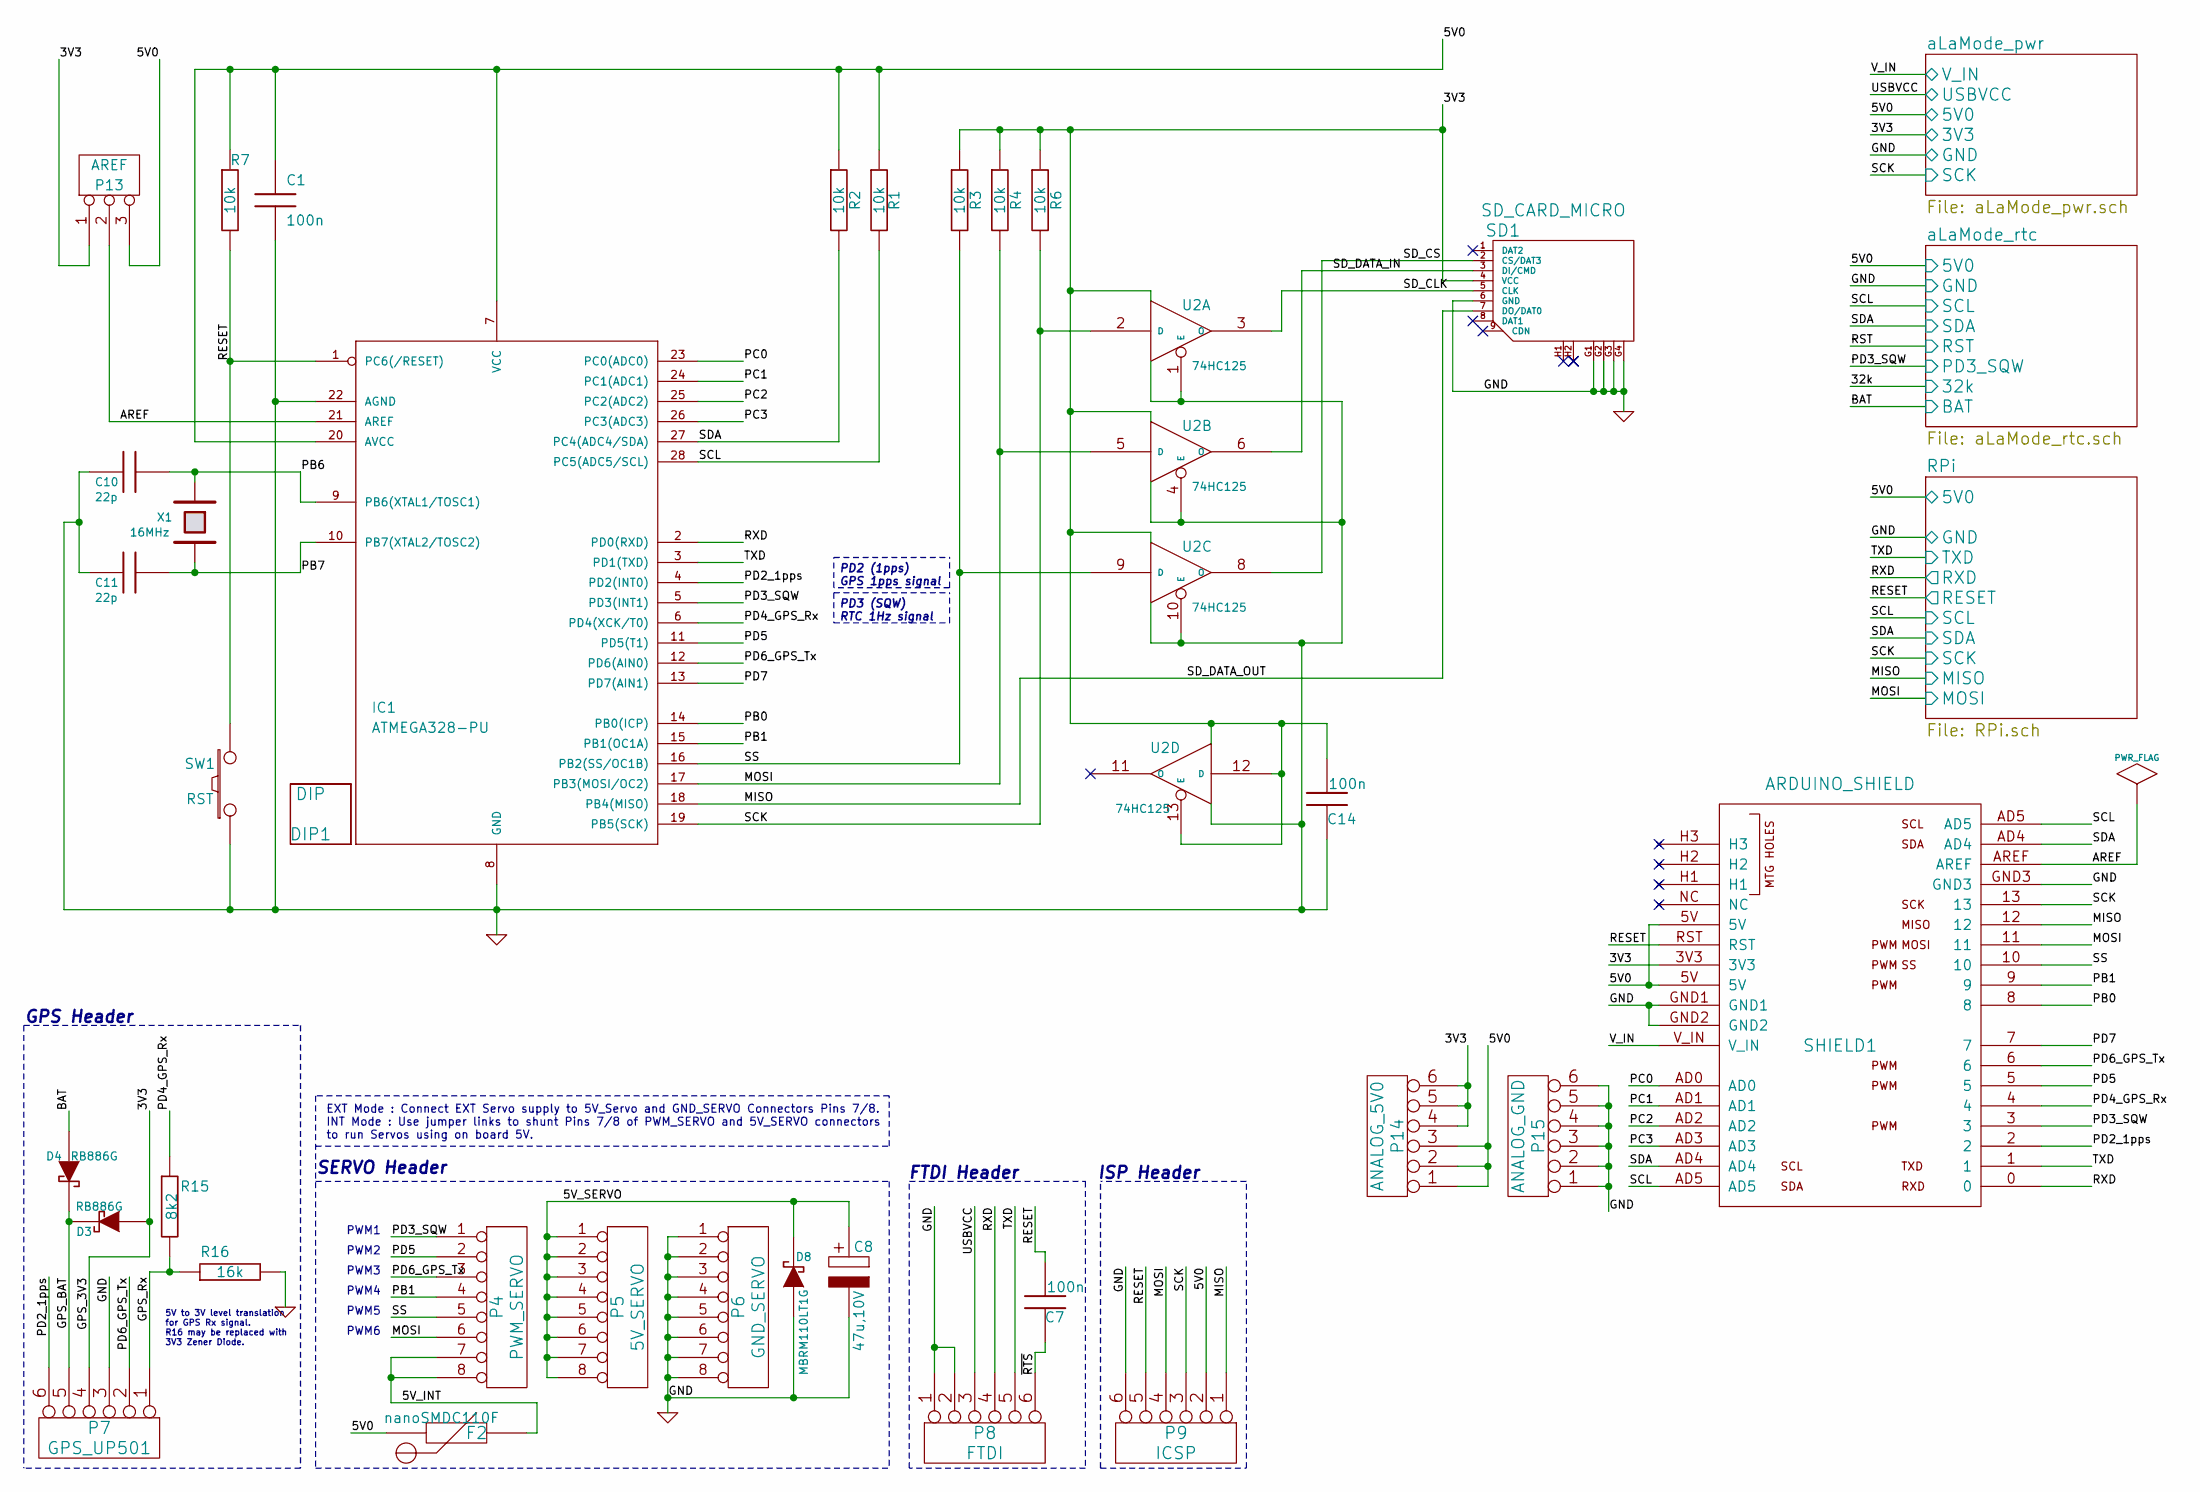
[picture p17: schematic aLaMode_v3.sch]

Parts:
C1, C7, C14: 100n; c_0805
C8: 47u,10V; C_ELCO_SMD
C10, C11: 22p; c_0805
D3, D4: RB886G; d_VMD2
D8: MBRM110LT1G; do_457
DIP1: DIP
F2: nanoSMDC110F; f_1206
IC1: ATMEGA328-PU; DIP-28__300_ELL
P4: PWM_SERVO; Header_Servo
P5: 5V_SERVO; Header_Servo
P6: GND_SERVO; Header_Servo
P7: GPS_UP501; Header_GPS
P8: FTDI; Header_FTDI
P9: ICSP; Header_ICSP
P13: AREF; Header_A_REF
P14: ANALOG_5V0; Header_6x1
P15: ANALOG_GND; Header_6x1
R1, R2, R3, R4, R6, R7: 10k; r_0805
R15: 8k2; r_0805
R16: 16k; r_0805
SD1: SD_CARD_MICRO; SD_Micro
SHIELD1: ARDUINO_SHIELD; ARDUINO_SHIELD_2_040pins
SW1: RST; SW_SMD
U2: 74HC125; SO14E
X1: 16MHz; Xtal_SMD2

Connections:
/5V_INT: F2.2, P4.7, P4.8
/5V_SERVO: C8.1, D8.2 (K), P5.1, P5.2, P5.3, P5.4, P5.5, P5.6, P5.7, P5.8
/AREF: IC1.21 (AREF), P13.2, SHIELD1.AREF
/GPS_BAT: D3.2 (K), D4.2 (K), P7.5
/GPS_Rx: P7.1, R15.2, R16.1
/PB0: IC1.14 (PB0(ICP)), SHIELD1.8
/PB1: IC1.15 (PB1(OC1A)), P4.4, SHIELD1.9
/PB6: C10.1, IC1.9 (PB6(XTAL1/TOSC1)), X1.1
/PB7: C11.1, IC1.10 (PB7(XTAL2/TOSC2)), X1.2
/PC0: IC1.23 (PC0(ADC0)), SHIELD1.AD0
/PC1: IC1.24 (PC1(ADC1)), SHIELD1.AD1
/PC2: IC1.25 (PC2(ADC2)), SHIELD1.AD2
/PC3: IC1.26 (PC3(ADC3)), SHIELD1.AD3
/PD2_1pps: IC1.4 (PD2(INT0)), P7.6, SHIELD1.2
/PD4_GPS_Rx: IC1.6 (PD4(XCK/T0)), R15.1, SHIELD1.4
/PD5: IC1.11 (PD5(T1)), P4.2, SHIELD1.5
/PD6_GPS_Tx: IC1.12 (PD6(AIN0)), P4.3, P7.2, SHIELD1.6
/PD7: IC1.13 (PD7(AIN1)), SHIELD1.7
/RPi/5V0: C1.1, F2.1, IC1.7 (VCC), IC1.20 (AVCC), P9.2, P13.3, P14.1, P14.2, P14.3, R1.1, R2.1, R7.1, SHIELD1.5V; also elsewhere on the board
/RPi/MISO: IC1.18 (PB4(MISO)), P9.1, SD1.7 (DO/DAT0), SHIELD1.12; also elsewhere on the board
/RPi/MOSI: IC1.17 (PB3(MOSI/OC2)), P4.6, P9.4, R4.2, SHIELD1.11, U2.5 (D); also elsewhere on the board
/RPi/RESET: C7.2, IC1.1 (PC6(/RESET)), P9.5, R7.2, SHIELD1.RST, SW1.2; also elsewhere on the board
/RPi/RXD: IC1.2 (PD0(RXD)), P8.4, SHIELD1.0; also elsewhere on the board
/RPi/SCK: IC1.19 (PB5(SCK)), P9.3, R6.2, SHIELD1.13, U2.2 (D); also elsewhere on the board
/RPi/SCL: IC1.28 (PC5(ADC5/SCL)), R1.2, SHIELD1.AD5; also elsewhere on the board
/RPi/SDA: IC1.27 (PC4(ADC4/SDA)), R2.2, SHIELD1.AD4; also elsewhere on the board
/RPi/TXD: IC1.3 (PD1(TXD)), P8.5, SHIELD1.1; also elsewhere on the board
/SD_CLK: SD1.5 (CLK), U2.3 (O)
/SD_CS: SD1.2 (CS/DAT3), U2.8 (O)
/SD_DATA_IN: SD1.3 (DI/CMD), U2.6 (O)
/SS: IC1.16 (PB2(SS/OC1B)), P4.5, R3.2, SHIELD1.10, U2.9 (D)
/aLaMode_pwr/USBVCC: P8.3; also elsewhere on the board
/aLaMode_pwr/V_IN: SHIELD1.V_IN; also elsewhere on the board
/aLaMode_rtc/BAT: D4.1 (A); also elsewhere on the board
/aLaMode_rtc/PD3_SQW: IC1.5 (PD3(INT1)), P4.1, SHIELD1.3; also elsewhere on the board
/~RTS: C7.1, P8.6
GND: C1.2, C8.2, C10.2, C11.2, C14.1, D8.1 (A), IC1.8 (GND), IC1.22 (AGND), P6.1, P6.2, P6.3, P6.4, P6.5, P6.6, P6.7, P6.8, P7.3, P8.1, P8.2, P9.6, P15.1, P15.2, P15.3, P15.4, P15.5, P15.6, R16.2, SD1.6 (GND), SD1.G1, SD1.G2, SD1.G3, SD1.G4, SHIELD1.GND1, SHIELD1.GND2, SHIELD1.GND3, SW1.1, U2.1 (E), U2.4 (E), U2.7 (GND), U2.10 (E); also elsewhere on the board
VCC: C14.2, D3.1 (A), P7.4, P13.1, P14.4, P14.5, P14.6, R3.1, R4.1, R6.1, SD1.4 (VCC), SHIELD1.3V3, U2.12 (D), U2.13 (E), U2.14 (VCC); also elsewhere on the board

Notes on the sheet:
PD3 (SQW) RTC 1Hz signal
FTDI Header
ISP Header
EXT Mode : Connect EXT Servo supply to 5V_Servo and GND_SERVO Connectors Pins 7/8. INT Mode : Use jumper links to shunt Pins 7/8 of PWM_SERVO and 5V_SERVO connectors to run Servos using on board 5V.
SERVO Header
PWM6
PWM5
PWM4
PWM3
PWM2
PWM1
GPS Header
PD2 (1pps) GPS 1pps signal
5V to 3V level translation for GPS Rx signal. R16 may be replaced with 3V3 Zener Diode.

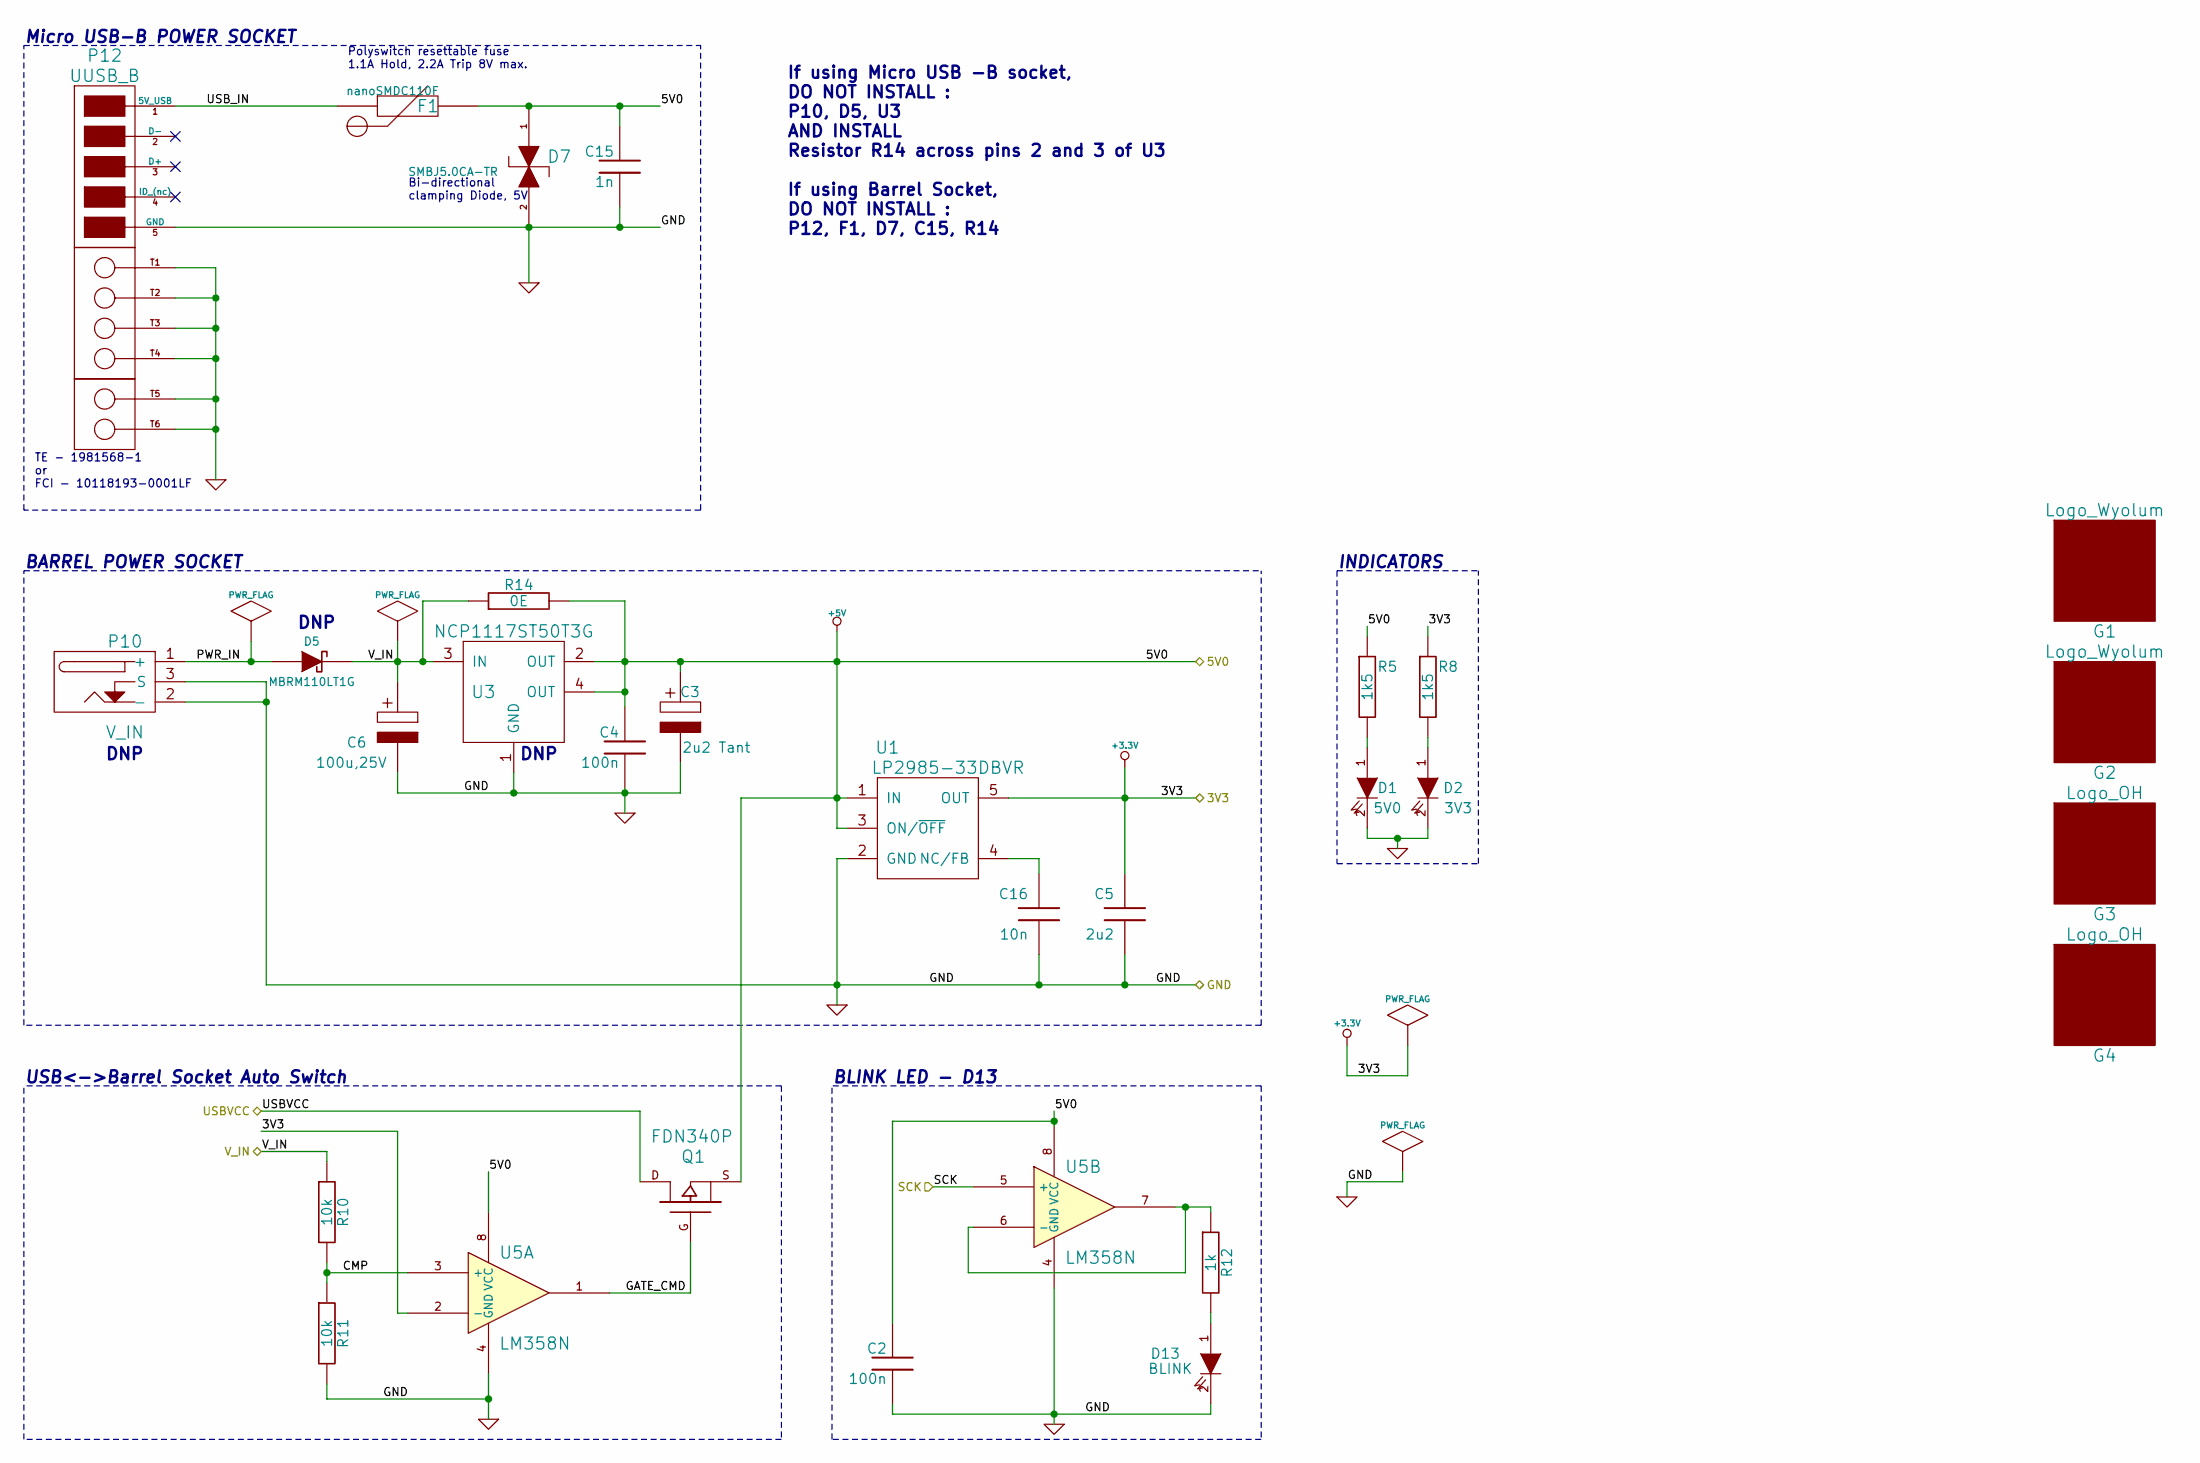
[picture p18: schematic aLaMode_pwr.sch, aLaMode_v3]

Parts:
C2, C4: 100n; c_0805
C3: 2u2 Tant; c_0805
C5: 2u2; c_0805
C6: 100u,25V; C_ELCO_SMD
C15: 1n; c_0805
C16: 10n; c_0805
D1: 5V0; led_0805
D2: 3V3; led_0805
D5: MBRM110LT1G; do_457
D7: SMBJ5.0CA-TR; diode-DO214AA
D13: BLINK; led_0805
F1: nanoSMDC110F; f_1206
G1, G2: Logo_Wyolum; Logo-WL3
G3, G4: Logo_OH; OSHW_6mm
P10: V_IN; JACK_ALIM
P12: UUSB_B; USB_B_Micro
Q1: FDN340P; SOT23-3
R5, R8: 1k5; r_0805
R10, R11: 10k; r_0805
R12: 1k; r_0805
R14: 0E; r_0805
U1: LP2985-33DBVR; SOT23-5
U3: NCP1117ST50T3G; SOT223
U5: LM358N; SO8E

Connections:
/RPi/5V0: C2.1, C3.1, C4.1, C15.1, D7.1, F1.2, Q1.S, R5.1, R14.2, U1.1 (IN), U1.3 (ON/~OFF), U3.2 (OUT), U3.4 (OUT), U5.8 (VCC); also elsewhere on the board
/RPi/SCK: U5.5 (+); also elsewhere on the board
/aLaMode_pwr/CMP: R10.2, R11.1, U5.3 (+)
/aLaMode_pwr/GATE_CMD: Q1.G, U5.1
/aLaMode_pwr/PWR_IN: D5.1 (A), P10.1 (+)
/aLaMode_pwr/USBVCC: Q1.D; also elsewhere on the board
/aLaMode_pwr/USB_IN: F1.1, P12.1 (5V_USB)
/aLaMode_pwr/V_IN: C6.1, D5.2 (K), R10.1, R14.1, U3.3 (IN); also elsewhere on the board
GND: C2.2, C3.2, C4.2, C5.2, C6.2, C15.2, C16.2, D1.2 (K), D2.2 (K), D7.2, D13.2 (K), P10.2 (-), P10.3 (S), P12.5 (GND), P12.T1, P12.T2, P12.T3, P12.T4, P12.T5, P12.T6, R11.2, U1.2 (GND), U3.1 (GND), U5.4 (GND); also elsewhere on the board
unnamed: C16.1, U1.4 (NC/FB)
unnamed: D1.1 (A), R5.2
unnamed: D2.1 (A), R8.2
unnamed: D13.1 (A), R12.2
unnamed: R12.1, U5.6 (-), U5.7
VCC: C5.1, R8.1, U1.5 (OUT), U5.2 (-); also elsewhere on the board

Notes on the sheet:
INDICATORS
BLINK LED - D13
USB<->Barrel Socket Auto Switch
BARREL POWER SOCKET
Micro USB-B POWER SOCKET
If using Micro USB -B socket, DO NOT INSTALL : P10, D5, U3 AND INSTALL Resistor R14 across pins 2 and 3 of U3 If using Barrel Socket, DO NOT INSTALL : P12, F1, D7, C15, R14
TE - 1981568-1 or FCI - 10118193-0001LF
Bi-directional clamping Diode, 5V
Polyswitch resettable fuse 1.1A Hold, 2.2A Trip 8V max.
DNP

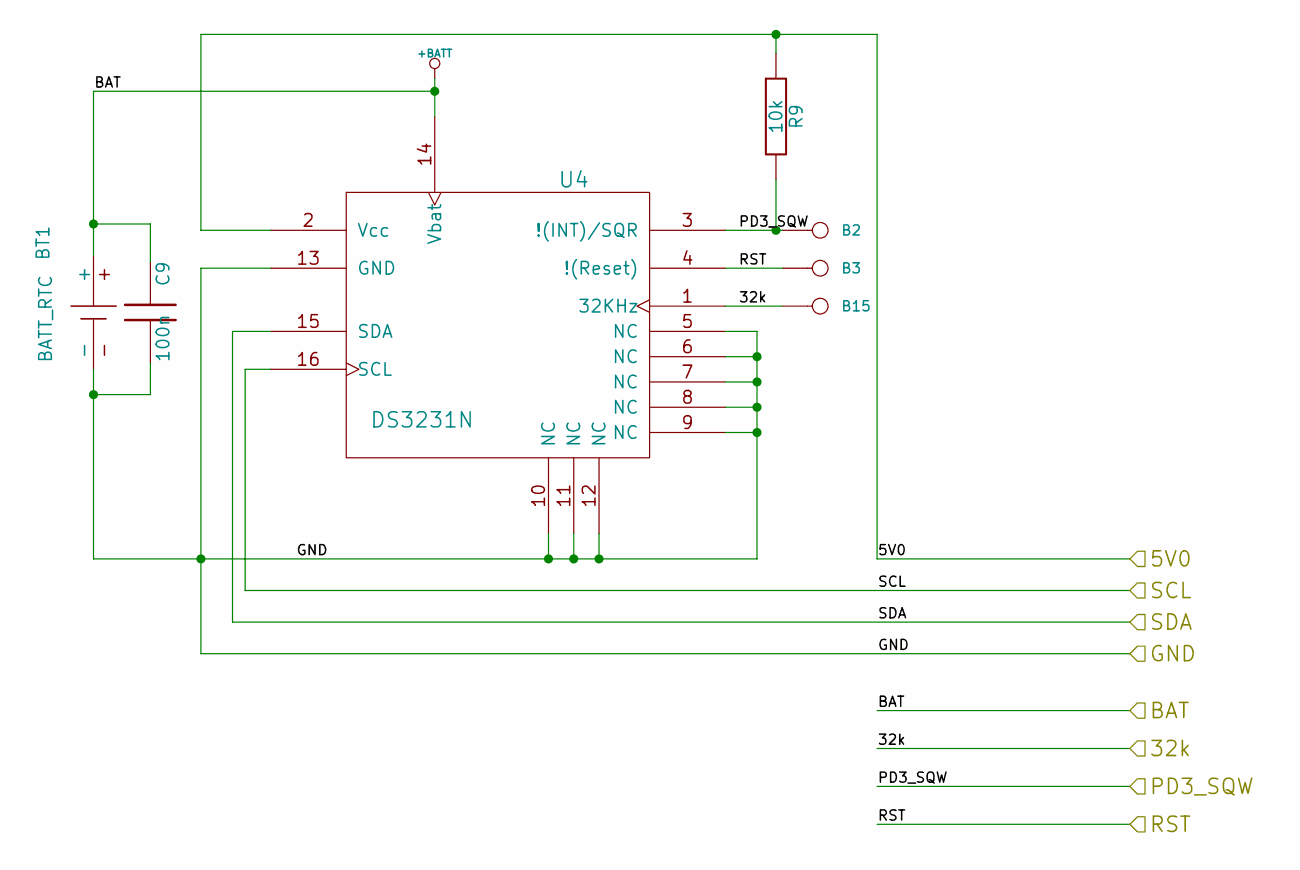
[picture p19: schematic aLaMode_rtc.sch, aLaMode_v3]

Parts:
B2, B3, B15: I/O; I_O
BT1: BATT_RTC; CR1632_2
C9: 100n; c_0805
R9: 10k; r_0805
U4: DS3231N; DS3231

Connections:
/RPi/5V0: R9.1, U4.2 (Vcc); also elsewhere on the board
/RPi/SCL: U4.16 (SCL); also elsewhere on the board
/RPi/SDA: U4.15 (SDA); also elsewhere on the board
/aLaMode_rtc/32k: B15.1, U4.1 (32KHz)
/aLaMode_rtc/BAT: BT1.+, C9.1, U4.14 (Vbat); also elsewhere on the board
/aLaMode_rtc/PD3_SQW: B2.1, R9.2, U4.3 (!(INT)/SQR); also elsewhere on the board
/aLaMode_rtc/RST: B3.1, U4.4 (!(Reset))
GND: BT1.-, C9.2, U4.5 (NC), U4.6 (NC), U4.7 (NC), U4.8 (NC), U4.9 (NC), U4.10 (NC), U4.11 (NC), U4.12 (NC), U4.13 (GND); also elsewhere on the board

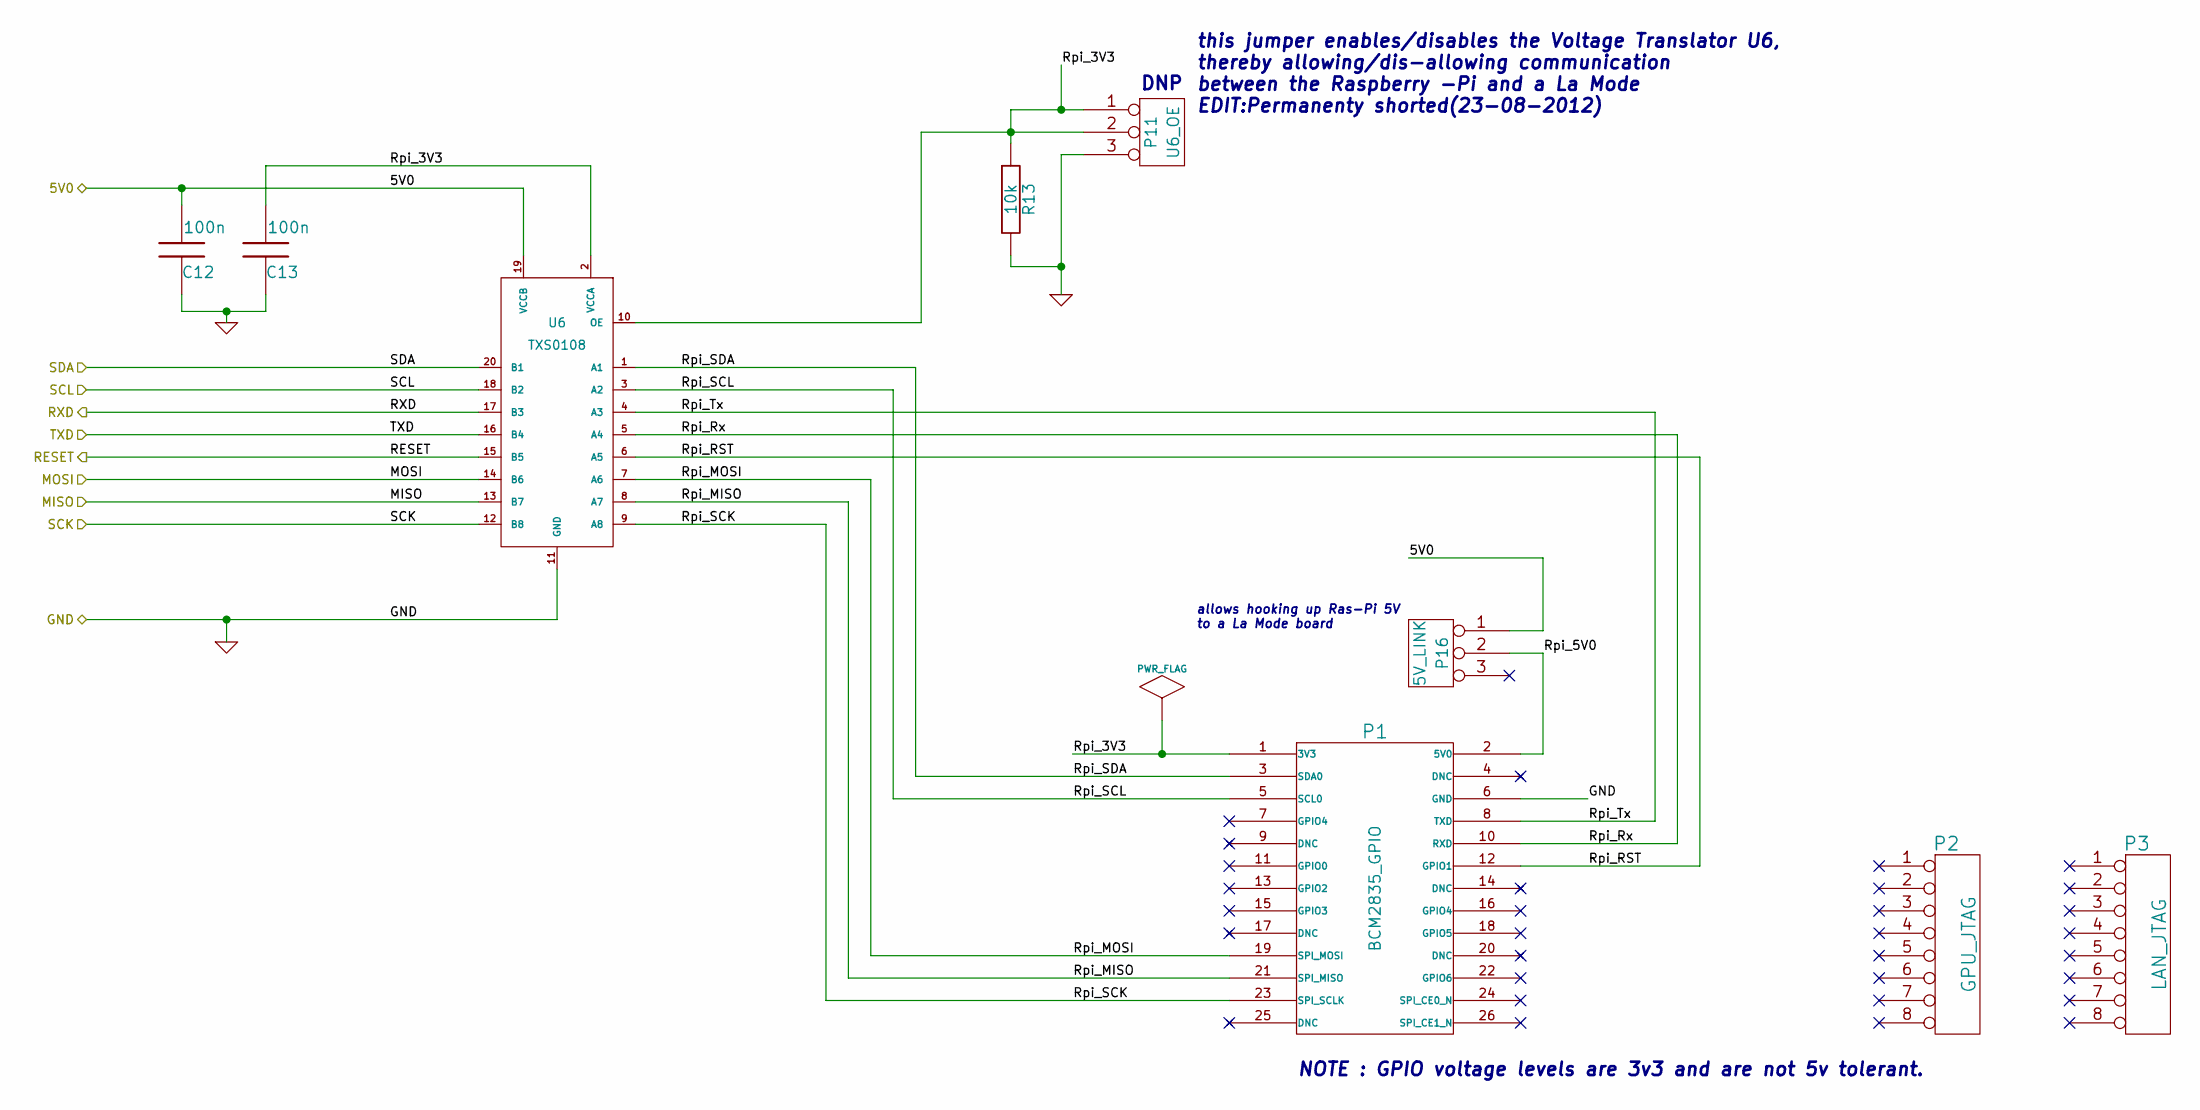
[picture p20: schematic RPi.sch, aLaMode_v3]

Parts:
C12, C13: 100n; c_0805
P1: BCM2835_GPIO; Header_GPIO
P2: GPU_JTAG; Header_GPU_JTAG
P3: LAN_JTAG; Header_GPU_JTAG
P11: U6_OE; Header_U6OE_SMT
P16: 5V_LINK; Header_U6OE_SMT
R13: 10k; r_0805
U6: TXS0108; tssop-20

Connections:
/RPi/5V0: C12.2, P16.1, U6.19 (VCCB); also elsewhere on the board
/RPi/MISO: U6.13 (B7); also elsewhere on the board
/RPi/MOSI: U6.14 (B6); also elsewhere on the board
/RPi/RESET: U6.15 (B5); also elsewhere on the board
/RPi/RXD: U6.17 (B3); also elsewhere on the board
/RPi/Rpi_3V3: C13.2, P1.1 (3V3), P11.1, P11.2, R13.1, U6.2 (VCCA), U6.10 (OE)
/RPi/Rpi_5V0: P1.2 (5V0), P16.2
/RPi/Rpi_MISO: P1.21 (SPI_MISO), U6.8 (A7)
/RPi/Rpi_MOSI: P1.19 (SPI_MOSI), U6.7 (A6)
/RPi/Rpi_RST: P1.12 (GPIO1), U6.6 (A5)
/RPi/Rpi_Rx: P1.10 (RXD), U6.5 (A4)
/RPi/Rpi_SCK: P1.23 (SPI_SCLK), U6.9 (A8)
/RPi/Rpi_SCL: P1.5 (SCL0), U6.3 (A2)
/RPi/Rpi_SDA: P1.3 (SDA0), U6.1 (A1)
/RPi/Rpi_Tx: P1.8 (TXD), U6.4 (A3)
/RPi/SCK: U6.12 (B8); also elsewhere on the board
/RPi/SCL: U6.18 (B2); also elsewhere on the board
/RPi/SDA: U6.20 (B1); also elsewhere on the board
/RPi/TXD: U6.16 (B4); also elsewhere on the board
GND: C12.1, C13.1, P1.6 (GND), P11.3, R13.2, U6.11 (GND); also elsewhere on the board

Notes on the sheet:
allows hooking up Ras-Pi 5V to a La Mode board
this jumper enables/disables the Voltage Translator U6, thereby allowing/dis-allowing communication between the Raspberry -Pi and a La Mode EDIT:Permanenty shorted(23-08-2012)
NOTE : GPIO voltage levels are 3v3 and are not 5v tolerant.
DNP

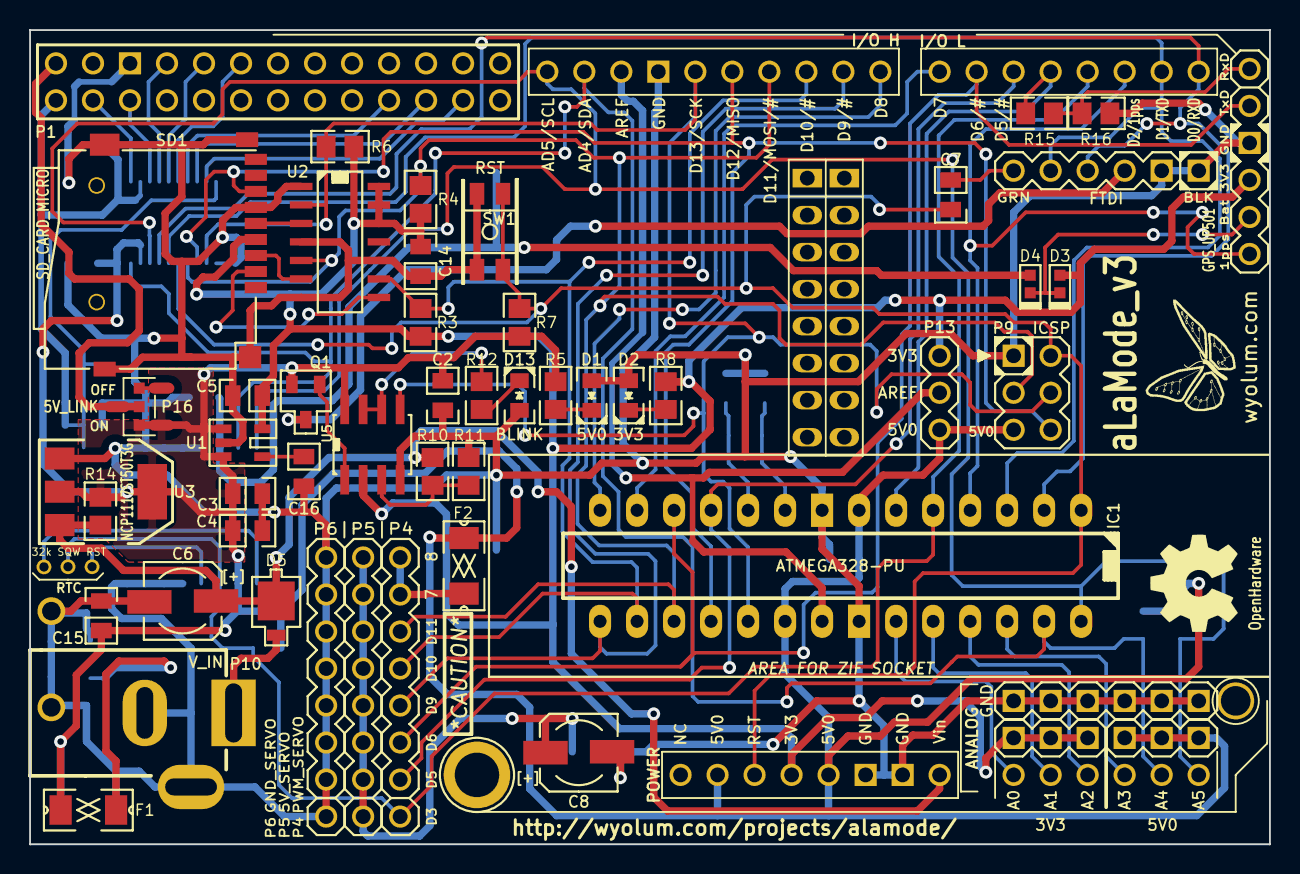
[picture p21: board aLaMode_v3.kicad_pcb from above]

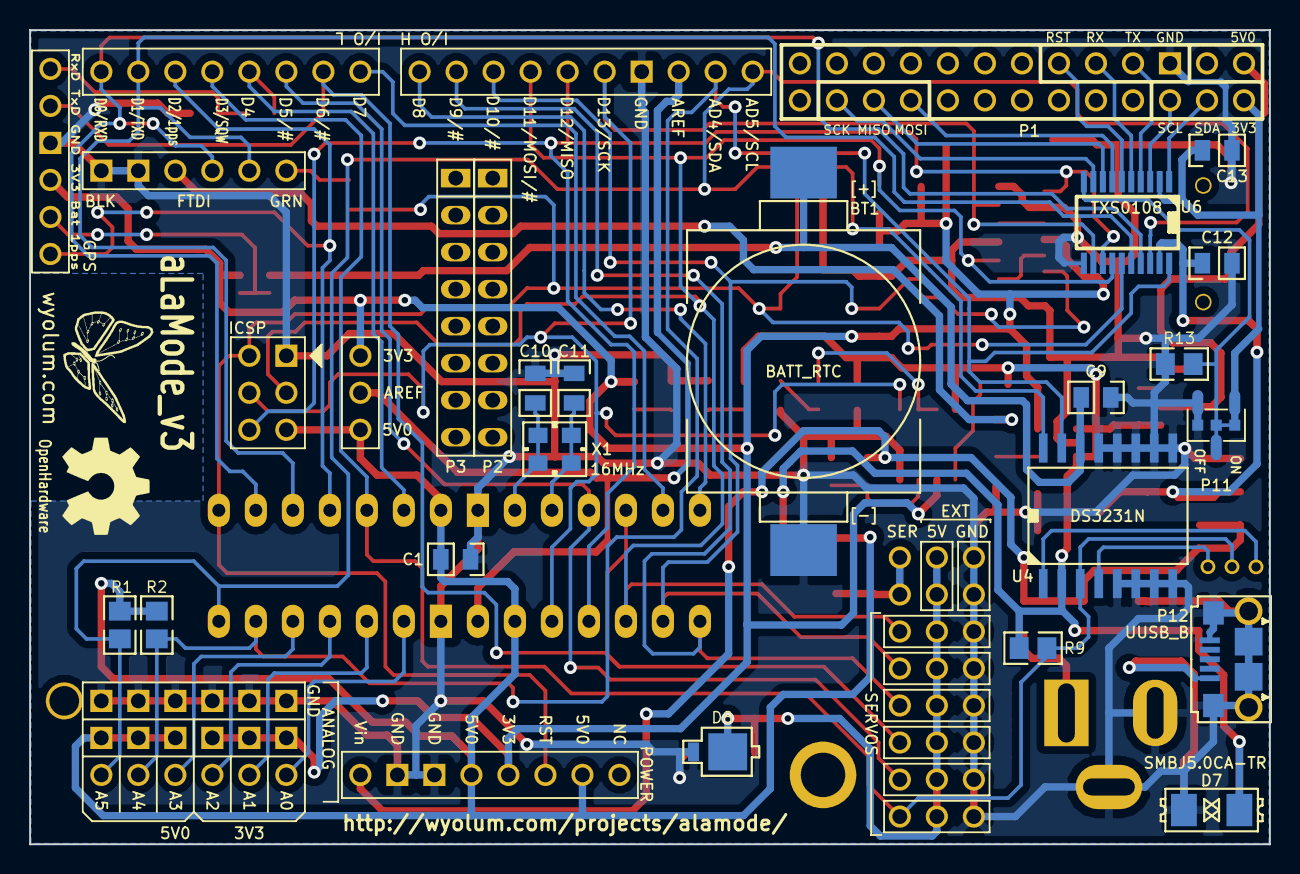
[picture p22: board aLaMode_v3.kicad_pcb from below]

Board: 2 copper layers, 85.1 x 55.9 mm, 79 parts (22 on the bottom side), 59 nets.
