wyolum/alamode/(commit log)

2012-09-07 Add Arduino test code for UUT and tester
2012-09-16 Initial commit, integrated arduino bundle
2012-10-24 Add CPUstats example (arduino code)
2015-07-27 footprint library upgrade, upgraded to .pretty
    [RPi.sch, Seeed BOM_aLamode_v3.ods, Seeed BOM_aLamode_v3.xls, aLaMode_misc.sch, aLaMode_pwr.sch, aLaMode_rtc.sch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]
2015-07-29 added 3D models folder
    [Seeed BOM_aLamode_v3.ods, Seeed BOM_aLamode_v3.xls, aLaMode_v3.kicad_pcb, aLaMode_v3.stl, alamode.stp]
2015-07-31 added 3D models
    [aLaMode_v3.stl, alamode.stp]
